12mv2/robo-bump-truck-build/docs/research/corrections.md

# Corrections

Author: Colin Rooney · © 2026 Rooney Industries LLC · MIT licence

This page lists numbers and claims from the research record that were withdrawn or corrected, and why. Each row gives what was said, what is said now, where each is recorded, and the date of the correction. Where a row replaces a figure, the figure on the other pages is the new one. The results are on [results](results.md), the instruments on [method](method.md), and the limits on [cannot-do-yet](cannot-do-yet.md).

One row, the weak direction, records two entries that disagree. It is not resolved.

## The truck and its parts

| Subject | What was said | What is said now | Where each is recorded | Date |
|---|---|---|---|---|
| Wheelbase | The record carried 0.269 m <!-- S:72 -->. An earlier controller used the same 0.269 m (pose_follow.py:50 at commit 14bc70a, code history). A rough tape gave 254 mm <!-- G:192 -->. Later the record said 0.28 m <!-- S:77 -->. | wheelbase: Traxxas spec 270 mm (https://traxxas.com/36054-8-110-stampede-xl-5-2wd-monster-truck-with-tq-radio; https://traxxas.com/36254-8-stampede-2wd-xl-5-wbattery, read 2026-10-10); measured 277.5 mm on this truck. The deployed controller does not use it; pure pursuit uses only the camera offset ahead of the rear axle, 0.24 m (src/orin/live_trail.py:2635 at f6ff42a, every run plan). The pages use the 277.5 mm measurement. <!-- spec: Traxxas pages linked inline; 277.5 mm: author's tape, 2026-10-10; 0.24 m: S:76, C:507 --> | Said: the research notes, the rough-tape table and the controller code. Now: the vendor pages and the author's tape. | 2026-10-10 |
| Camera height | The lens height was assumed to be about 300 mm <!-- F:400 -->, then measured at 260 mm <!-- F:400 -->. At 260 mm the look-ahead table was about 13 % optimistic, for example 0.83 m became 0.72 m at the normal pitch <!-- F:400 -->. | 290 mm from 2026-09-14, after spring spacers raised the truck <!-- F:1941, F:1947-1948 -->: 0.29 m to the upper lens, loaded and settled <!-- F:1947 -->, 0.2775 m fully compressed <!-- F:1948 -->. A ruler gave 0.29 m and the calibration images fit 0.29 to 0.31 m <!-- F:1941 -->. [Calibration](../calibration.md) uses 0.29 m. This is a change in the truck, not a mistake in the earlier measurement. | Said and now: the research log, entries of 2026-09-03 and 2026-09-14. | 2026-09-03 and 2026-09-14 <!-- F:400, F:1941 --> |
| Flight-controller connector margin | Any pocket, lip or wall on the tray would foul a connector on the flight controller. This was inferred from product photos <!-- F:468 -->. | There is a 2 mm clear margin on every face of the Pixhawk 6C Mini, including the top, before any connector. A 2 mm lip fouls nothing <!-- F:468 -->. A measurement outranks a photo. | Said and now: the research log, entry of 2026-09-05. | 2026-09-05 <!-- F:468 --> |
| Red light on the speed controller | Solid red on the XL-5 meant a low-voltage trigger <!-- F:976 -->. | Solid red means low-voltage detection is disabled (the NiMH setting). It is a power-on light, not a fault. Detection engaged is a slow blink and thermal shutdown a fast one <!-- F:976 -->. | Said and now: the research log, entry of 2026-09-08. | 2026-09-08 <!-- F:976 --> |
| Capture phone | The pose-capture phone was a co-mounted 14 Pro <!-- F:888 -->. | It is the 17 Pro. The 14 Pro never held pose outdoors: it lost it in 19 to 47 s on every 2026-08-29 session <!-- F:888 -->. | Said and now: the research log, entry of 2026-09-07. | 2026-09-07 <!-- F:888 --> |

## The oval and the steering head

| Subject | What was said | What is said now | Where each is recorded | Date |
|---|---|---|---|---|
| Bend radius of the tape oval | The bends had a 1.3 m radius, needing a curvature of 0.77 1/m <!-- F:1016, F:1030 -->. This figure is withdrawn. | The bend end radii are 0.65 to 0.82 m, from four sessions of phone pose, and need a curvature of 1.2 to 1.5 1/m <!-- F:1046, C:550-555 -->. The ceiling-camera circle fit gives 0.62 m for the tightest bend <!-- C:550-555 -->. These are two instruments on one tape and do not conflict; name the instrument when quoting either. | Said: research log, entry of 2026-09-09. Now: research log, entry of 2026-09-09. | 2026-09-09 <!-- F:1046 --> |
| Oval-head AUC | The steering head trained on the oval scored an AUC of 0.94 to 0.97 on held-out sessions <!-- F:1005 -->. This figure is withdrawn. | AUC is the wrong headline for this head. It is inflated by easy negatives: one patch of 34 per row is the centre, so ruling out the far edges scores well <!-- F:1031 -->. The honest numbers are a column error of 3 to 6 cm and a correlation of +0.49 with the driver <!-- F:1031, C:540-547 -->. The author caught it: the AUC looked too good to be true. | Said: research log, entry of 2026-09-08. Now: research log, entry of 2026-09-09. | 2026-09-09 <!-- F:1031 --> |

## Direction

| Subject | What was said | What is said now | Where each is recorded | Date |
|---|---|---|---|---|
| Turn direction sign | The weak direction was left turns. A 6 cm camera offset explained why the inside tape left the view sooner in a left turn <!-- F:1459 -->. | Positive curvature is a right steer. The weak direction is right turns, which is clockwise, the way the author drove <!-- F:1468, C:397-414 -->. The numbers stand: in right turns 8 to 13 rows were seen, 54 % of frames were gated and the command never exceeded 1.17; in left turns 15 rows were seen, 37 % were gated and the command reached 1.58 <!-- F:1468 -->. The 6 cm camera-offset explanation was told with the wrong sign and is withdrawn <!-- F:1468, C:397-414 -->. | Said: research log, entry of 2026-09-12. Now: erratum in the research log, 2026-09-13. | 2026-09-13 <!-- F:1468 --> |
| Weak direction, open conflict | An erratum of 2026-09-13 says the weak direction is right turns, clockwise <!-- F:1468, C:401-404 -->. | A later note, 2026-09-24, attributes the same command limit to turning left: "turning left the command never exceeded 1.17 1/m against a bend that needs ~1.6" <!-- F:1490-1491 -->. The two entries disagree on the side. This page does not resolve it. The statements on [results](results.md) name no side and say "its weak direction" <!-- C:417-418 -->. [Cannot-do-yet](cannot-do-yet.md) names clockwise once, quoting the corner-by-corner result of 2026-09-12 that the record allows <!-- C:414-416, F:1500-1501 -->; that result is not the one in conflict here. | Said and now: research log, the erratum of 2026-09-13 and the note of 2026-09-24. | 2026-09-13 and 2026-09-24 <!-- F:1468, F:1491 --> |

## Runs, gates and the controller

| Subject | What was said | What is said now | Where each is recorded | Date |
|---|---|---|---|---|
| The "v13 cell" | Five graded runs on 2026-09-11, with median worst cross-track errors of 0.065, 0.049 and 0.070 m at entry, apex and exit, were a steering-head result <!-- F:1297 -->. | The radio steered them. The [mode switch](../radio-and-controller.md) sat in the middle band and the steering-source dial at its low end, which gives the steering head a weight of 0.0 <!-- F:1290 -->. The cell was not driven. Quote the three numbers only as a hand-steered reference at cruise throttle <!-- F:1297, C:707-722 -->. The first graded set the steering head did steer that night read 0.126, 0.438 and 0.414 m <!-- F:1312 -->. | Said and now: research log, entry of 2026-09-11. | 2026-09-11 <!-- F:1290 --> |
| Gate counts | "The gates are quiet now: 28 gated frames of 3,633" <!-- F:1666 -->. | The gate field says 1,152 of 3,633 frames, 31.7 % <!-- F:1725 -->. The 28 counted states (13 low-row, 11 lane and 4 hold), not the gate. | Said and now: research log, entry of 2026-09-13. | 2026-09-13 <!-- F:1725 --> |
| Share of the line fitter | The fitter's straight-line fallback was worth about 10 % <!-- F:1656 -->. | Withdrawn as a decomposition. The replay left out the deployed row-vote mask. With it, uncapping the fit changed 333 of 1,065 fresh bend requests by more than 0.1, and on the 577 straight-fit bend frames the median change was −0.054, slightly less turning <!-- F:1728 -->. | Said and now: research log, entry of 2026-09-13. | 2026-09-13 <!-- F:1728 --> |
| Detection rejection rate | 99.2 % of false detections were rejected <!-- F:2196 -->. | The denominator was colour-mask-negative frames, not false detections. Of 259 such frames, 257 were gated and 2 were acted on <!-- F:2195 -->. A gated frame means the fresh camera fit was not used. It does not mean the truck stopped <!-- F:2196 -->. | Said and now: research log, entry of 2026-09-14 and 2026-09-15. | 2026-09-14 <!-- F:2196 --> |
| External stall guard | An external stall guard bounds a wound-up speed loop to 2.5 s <!-- F:1927-1928 -->. | The guard has been superseded by the motion checks in the recovery code, and the entry is kept as the measurement of the hazard. The truck still did not move on the retry <!-- F:1928 -->. See [pitfalls](../pitfalls.md) and [power and safety](../power-and-safety.md). | Said and now: the research log, one entry of 2026-09-14. | 2026-09-14 <!-- F:1928 --> |

## Instruments and capture

| Subject | What was said | What is said now | Where each is recorded | Date |
|---|---|---|---|---|
| Decoder latency | One frame held, 94 ms, and 227 ms from capture to record, on the Orin's hardware video decoder <!-- F:1534, F:1595-1596 -->. | Withdrawn as latency figures. The picture the steering head would steer on was 11 to 13 frames, 0.7 to 0.9 s, older than its tag, and the stamps were about 11 frames wrong <!-- F:1579, F:1595-1596 -->. The software-decoder figure of 287 ms stands <!-- F:1595-1596 -->. | Said: research log, entries of 2026-09-13. Now: the erratum of 2026-09-13, 02:20. | 2026-09-13 <!-- F:1579 --> |
| Ground-frame rotation | A per-pass rotation of a few degrees, up to 6.2°, was a rigid rotation of the phone's frame <!-- F:2419 -->. | It is not rigid in 45 of 55 passes, 82 % <!-- F:2463 -->. The rotation needed varied by a median of 7.75° along one pass, against 2.94° at the 90th percentile in a positive control <!-- F:2463 -->. What survives: the phone and gyro disagree most at the same corners every lap, up to 4.6 to 6.4° <!-- F:2463 -->. | Said and now: research log, entry of 2026-09-20. | 2026-09-20 <!-- F:2463 --> |
| Phone orientation and walk length | The phone was held landscape, and the capture walks lasted about 10 min <!-- C:122, C:123 -->. | The phone was held portrait <!-- C:17 -->. The walks were 213.6 s, 228.6 s and 91.8 s, or 3.6, 3.8 and 1.5 min, measured from the video files <!-- C:49, C:122-123 -->. | Said: earlier publication drafts. Now: corrected in those drafts the same day. | 2026-08-30 <!-- C:122-123 --> |
