12mv2/robo-bump-truck-build/prints/phone-cradle/v26_riser.stl

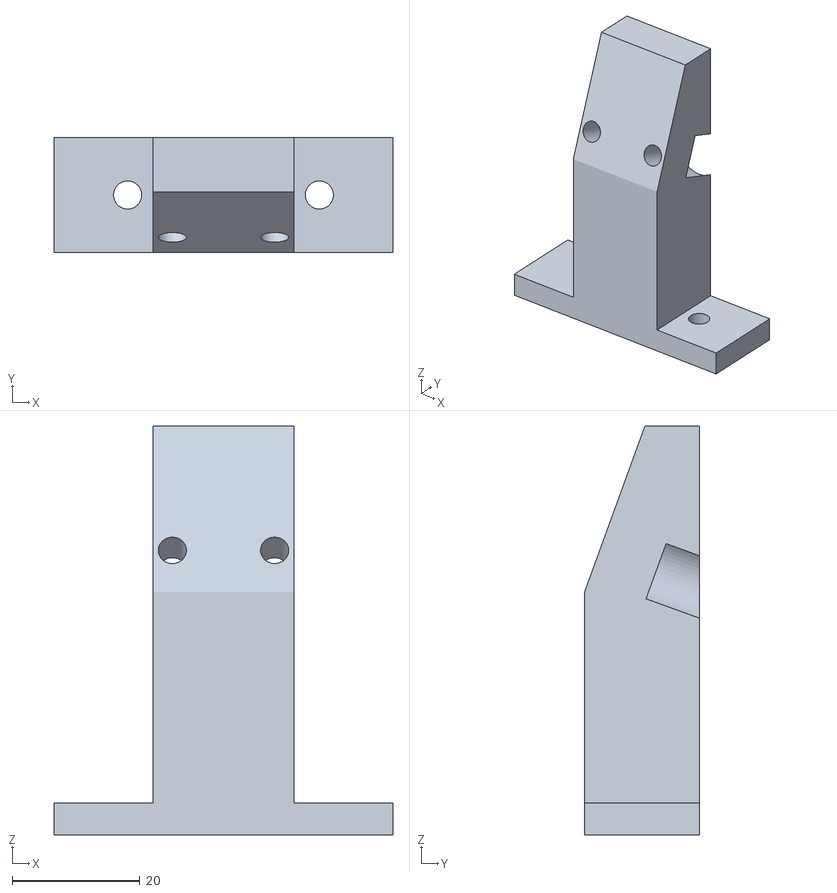
[picture p5: CAD file, 2026-10-20]
prints/phone-cradle/v26_riser.stl
53.0 x 18.0 x 64.0
