12mv2/robo-bump-truck-build/prints/phone-cradle/v66_tbar.stl

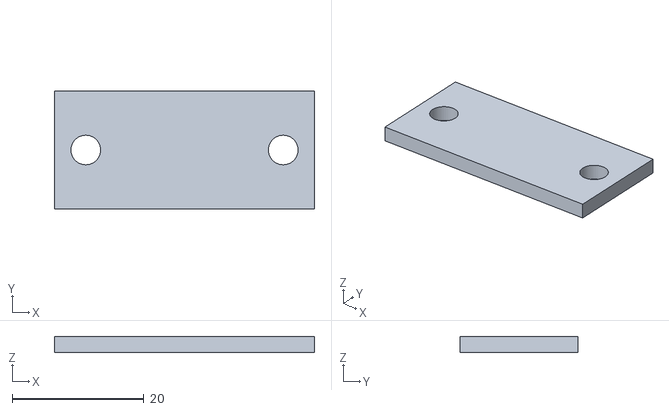
[picture p6: CAD file, 2026-10-20]
prints/phone-cradle/v66_tbar.stl
39.5 x 18.0 x 2.50
