12mv2/robo-bump-truck-build/prints/phone-cradle/v21b_pin.stl

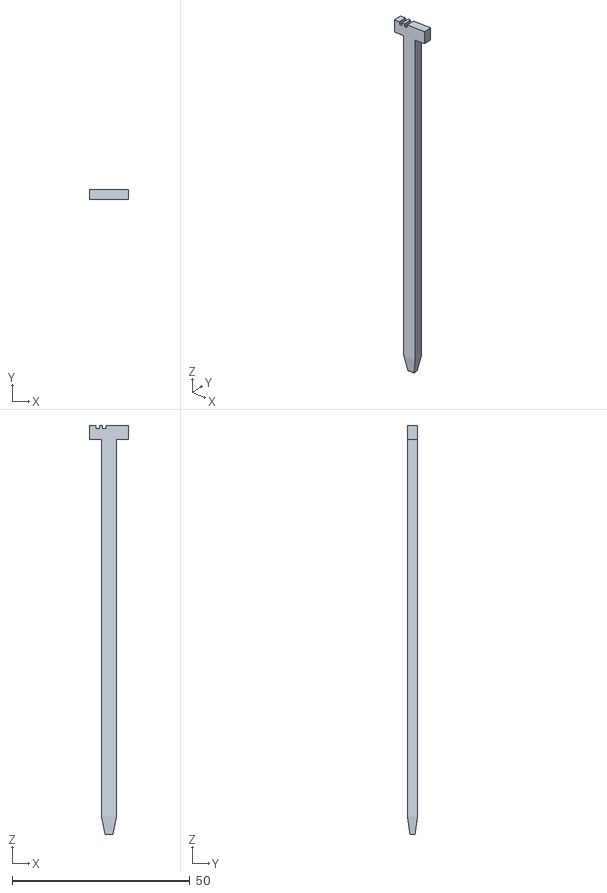
[picture p7: CAD file, 2026-10-20]
prints/phone-cradle/v21b_pin.stl
11.0 x 2.85 x 115.0
