12mv2/robo-bump-truck-build/prints/phone-cradle/v26_tray.stl

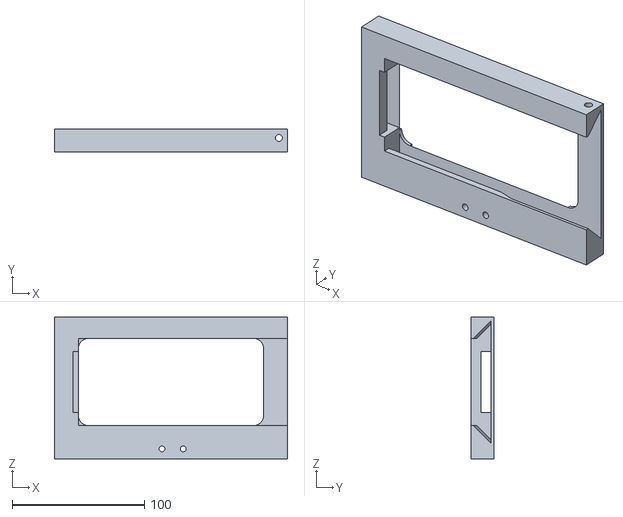
[picture p8: CAD file, 2026-10-20]
prints/phone-cradle/v26_tray.stl
176.0 x 17.2 x 107.0
