12mv2/robo-bump-truck-build/prints/phone-cradle/v10_wedge5.stl

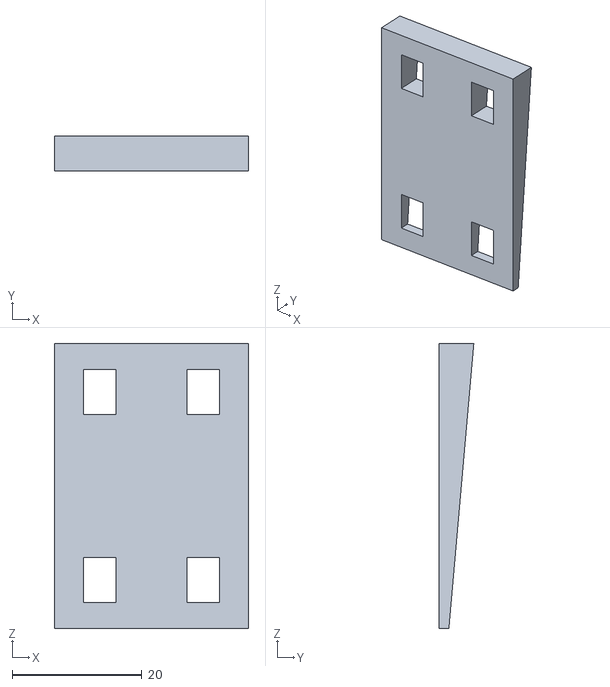
[picture p9: CAD file, 2026-10-20]
prints/phone-cradle/v10_wedge5.stl
30.0 x 5.35 x 44.0
