12mv2/robo-bump-truck-build/docs/build-checkpoints.md

# Build checkpoints

Author: Colin Rooney · © 2026 Rooney Industries LLC · MIT licence

Choose the checkpoint for your route; the public ROS interface is independent of unpowered assembly or cradle printing. The [physical build completion list](assembly.md#build-completion-list) is the canonical list of selected-mount checks and outstanding commissioning inputs. The full physical build remains the goal, but the historical guide is not a complete commissioned recipe or a validated current controller.

| Checkpoint | Actual prerequisites | Result and practical pass/stop observations | Availability |
|---|---|---|---|
| 1. Public ROS interface and outputs-disabled diagnostics | Supported ROS Linux host and the tools/dependencies in the [ROS README](https://github.com/12mv2/robo-bump-truck-ros#build-and-test); no vehicle, phone, prints or weights. | Build/tests plus actual topic delivery under the [shadow bridge guide](https://github.com/12mv2/robo-bump-truck-ros/blob/main/truck_bridge/README.md#build-and-run). Retain repeated normal, zero-speed and steering-handback diagnostics, with outputs disabled, and process shutdown observations. Stop if delivery is absent, publishers compete or status differs from the guide. | Public instructions and interface are available. Written readiness and unit tests do not establish a new ROS demonstration. |
| 2. Recorded-frame perception replay, no vehicle | Host/runtime from [Jetson and perception setup](https://github.com/12mv2/robo-bump-truck-ros/blob/main/docs/jetson-orin-setup.md), node-owner supplied node package, permitted model, configuration and usable recorded images with the expected format/calibration. Keep vehicle interfaces physically disconnected. | Observe decoded frames, node predictions and real ROS message/status delivery; record input/model/config identities and clean process exits. Stop on missing assets, decode/model errors or absent messages. A running process alone does not pass. | Setup guide and [agent brief](https://github.com/12mv2/robo-bump-truck-ros/blob/main/AGENT-BRIEF.md) are public; the interface repository does not supply the perception runtime, model, configuration or replay images. |
| 3. Physical assembly, radio, steering and camera commissioning | Verified [parts](parts.md), secure selected mounts (bands/straps and optional trays, or fitted [reference prints](prints.md)) and own-build [measurements](calibration.md). Establish a [simple manual baseline](radio-and-controller.md#start-simple) with manufacturer instructions and a known-working wheel/trigger setup; the stock radio can precede receiver changes. Advanced research mixes and compute ownership are optional later work. Manual use through Pixhawk requires correct firmware/configuration, owner-reviewed [radio/controller configuration](radio-and-controller.md#missing-commissioning-inputs) and [power isolation](power-and-safety.md#commissioning-and-isolation). | Later supervised bench evidence must show secure assembly, correct channel/direction/endpoints, neutral when disarmed, effective kill/manual override, link-loss and expiry behaviour. Stop for binding, unexpected output, missing configuration or unproven stopping. Future assisted powered drive also requires the controller boundary and acceptance in checkpoint 4. | Historical release identities, partial commissioning facts and five [phone-cradle reference prints](../prints/phone-cradle/README.md) are supplied; historical compute/FC carrier files and exact fitted identities are optional references, not unpowered-assembly prerequisites. Mounting and outputs-disabled ROS do not require advanced controls. Full firmware/parameter/mixer exports and the intended controller package remain outstanding. No new physical commissioning is established here. |
| 4. Intended-controller supervised first drive | Source-owner reviewed suitable controller/configuration, accepted bench evidence, verified stopping and supervised field plan under the [first-drive boundary](first-drive.md). Public ROS physical integration still needs an accepted output-owner path; the separate historical field relay is not supplied here; see [ROS connection](ros.md#how-it-connects-to-the-orin-stack). | Retain physical motion, stop, lane-loss/stale-intent, route-end and human-veto observations, plus shutdown/recovery evidence. Stop on any failure or unresolved throttle authority. | The historical field kit is identified separately. Its public package, rebuild instructions, full exports and new-build bench/field acceptance remain outstanding. Historical drives do not validate this snapshot for a new build. |

Node-owner assets not supplied by this repository (model/configuration/replay images) are separate from this truck's unpublished [OVAL4 head](../model/README.md) and unavailable [sample assets](../data/README.md). OVAL4 belongs only to the historical DINO truck snapshot, separate from the manually launched field kit; neither it nor sample logs are required for synthetic ROS. The described samples exclude video/images and cannot supply a recorded-frame replay. Historical perception also needs its local DINOv2 checkout/checkpoint and verified runtime setup; see [Orin setup](orin-setup.md). Robot Eyes is **CLOSED SOURCE**; [app distribution and device access](ros.md#robot-eyes-the-phone-app) are separate prerequisites for a later live-phone path.

The [separate dated field integration](ros.md#how-it-connects-to-the-orin-stack) did have powered use; it does not validate public `truck_bridge`. Source identity alone establishes neither a reproducible public package nor fresh physical acceptance.

In the historical snapshot source, omitting `--fc` selects compute-only operation. With `--fc --dry-run`, the program connects to the flight controller and exchanges telemetry/parameter traffic while actuator override sends are disabled; this is not physical disconnection or absence of protocol traffic. <!-- src/orin/live_trail.py:673-692,1584-1590,2062-2068,2158 -->

Keep evidence distinct: written prerequisites, build/tests, actual ROS transport and process exits, replay artifacts, physical commissioning and recovery, then full fresh-follow acceptance. No checkpoint is marked passed by this page. A fresh reader must eventually complete the first drive from the tagged guide and parts list without an author answer; intermediate demos do not establish that result. The first independent fresh-follow build will take place **after public release**; no pass has been recorded. This does not relax source-owner review or powered bench/field acceptance.
