12mv2/robo-bump-truck-build/prints/phone-cradle/INDEX.md

# Phone cradle package index

Start with [README.md](README.md) for fit limits, slicing and assembly.

| File | Contents |
|---|---|
| [README.md](README.md) | Reader instructions and recorded hardware |
| [MANIFEST.json](MANIFEST.json) | Author, licence, units, conversion and mesh hashes |
| [v26_tray.stl](v26_tray.stl) | Reference tray |
| [v26_riser.stl](v26_riser.stl) | Reference riser |
| [v66_tbar.stl](v66_tbar.stl) | Reference T-bar |
| [v21b_pin.stl](v21b_pin.stl) | Standard two-notch pin |
| [v10_wedge5.stl](v10_wedge5.stl) | Optional single 5° shim |
