12mv2/robo-bump-truck-build/src/orin/live_trail.py

#!/usr/bin/env python3
# SPDX-License-Identifier: MIT — © 2026 Rooney Industries LLC
"""LIVE trail-centre inference: iPhone -> DINOv2-S/14 (FP16) -> 385-param head -> line -> pure
pursuit -> RC override on the steering channel.  Rewritten 2026-09-06 (v2).

Current local control repair (2026-09-14): OutputOwner alone sends both channels,
at --wheel-hz in all switch positions. Frames publish an expiring Intent; every
cruise withdrawal inhibits restart until HOLD + bottom dial, pose standstill,
then raised dial in HOLD and an exit from HOLD. Optional --stall-recovery adds
one bounded XL-5 retreat, with validated FC configuration and downstream output
feedback. It remains off by default pending physical characterization. Command
tests are offline evidence; physical stopping acceptance is still required.

The learned head consumes RGB. The current controller also uses phone pose for
taught-path feed-forward, speed and motion checks, and live camera pitch when
requested. Depth-ahead and IMU shock telemetry are logged; they do not currently
provide obstacle-clearance or collision-stop control.

WHAT CHANGED FROM v1 (2026-09-06 review):
  * The line is drawn EXACTLY as validated against the operator's 53 strokes (line_rules_v1.py):
    mass-weighted per-row centroid, per-row confidence = mass within +-2 patches, keep rows with
    conf >= 0.4, mass-weighted cubic with quadratic/line fallback on a curvature cap.
    v1 used per-row argmax + a max-prob gate + an unweighted cubic, which was never measured.
    An offline check (not shipped) reproduces the validated line rules from THIS file's code.
  * Mount pitch is a flag (--pitch up|normal|down|<deg>), not a constant buried in the source.
  * The 6 cm camera-to-truck-centre offset is applied (FINDINGS 12).
  * It actually SENDS: RC_CHANNELS_OVERRIDE on the steering channel only, radio keeps every other channel.
    Release on exit, release after --hold-ms without a lane, sysid gate before the perception model loads.
  * --dry-run computes and logs everything and sends nothing (shadow mode while the operator drives).
  * v3 (2026-09-06, field iteration): every frame ALSO logs the radio (RC_CHANNELS: steering, throttle, mode switch, kill dial),
    the servo outputs (SERVO_OUTPUT_RAW 1/3), mode and armed state read back from the FC, and
    the 476x350 feed frame as a JPEG (feed/). In shadow mode the steering channel is the OPERATOR'S steering -- the free
    label grade_run.py fits gain/sign/lookahead against. In auto mode the steering channel is the override and
    servo1 proves it reached the wheels. --note records what changed for this run.
  * Every frame is logged (jsonl + probs npz + a jpg every --jpg-every frames) so a live run can
    be graded against strokes and replayed against any head afterwards.
  * --video runs the identical code path on a corpus rgb.mp4 -- no phone needed to test.
  * Optional --danger-head runs DangerNet on the same backbone pass (display/log only).
  * v6 (2026-09-08): OPTIONAL --cruise holds a fixed throttle on the RC throttle channel while the steering head
    steers, so a tuning pass is one cell (lookahead, gain) and not also a hand-throttle
    (ANALYSIS-2026-09-08-tuning-process 6B/9: "no sweep is interpretable" without it). Off by
    default; with no --cruise flag not one byte of the command path changes. The human's real
    trigger is read from the radio's trigger-copy mixer channel (the FC reports the OVERRIDE, not the stick,
    on an overridden channel -- the same trap the wheel copy solves for steering), and ANY
    trigger movement, HOLD, a mode change, a disarm or stale RC telemetry hands throttle straight
    back to the receiver.
  * v7 (2026-09-09): --min-rows refuses to steer on a line fitted through too few band rows and
    holds the last confident command instead (the sign reversal that lost the kitchen oval's
    corner happened on 6-9 rows). 0 = off, the pre-v7 behaviour exactly.
  * v8 (2026-09-09): OPTIONAL --kff CURVATURE FEED-FORWARD, off by default. Pure pursuit steers
    only on EXISTING lateral error, so it enters a bend late and runs wide at any gain -- bracketed
    from both ends on the kitchen oval in one hour (FINDINGS 36) and structural, not a knob
    (ANALYSIS-2026-09-08-tuning-process 9: Snider CMU-RI-TR-09-08 4.3, ETH MAP "drives wide in all
    corners"). kappa_total = kff*kappa_path + gain*kappa_pursuit, where kappa_path is the
    GROUND-FRAME curvature of the trail near the goal point, from a mass-weighted quadratic over
    the ground-projected per-row CENTROIDS in a window around the lookahead (see path_curvature:
    the tool's own fitted line is curvature-CAPPED and comes back straight on 84-97 % of bend
    frames, so its curvature is identically zero exactly where the term is needed). The
    feed-forward is clamped on its own (--kff-max) before the sum, needs more rows than the
    pursuit term (--kff-min-rows) plus its own window/points/residual test, and never fires on a
    frame --min-rows distrusts. With no --kff flag not one byte of the command path or of a frame
    record changes -- proven by a replay diff against v7. NOT YET BENCH-TESTED OR DRIVEN.
  * v9 (2026-09-09): the LINE FIT's curvature cap can be expressed in the GROUND FRAME
    (--cap-kappa, 1/m), and the fitted DEGREE is now logged on every frame (`fit_deg`). The
    shipped cap of 0.05 patches/row^2 is not a physical quantity: measured over 9 sessions it
    fires on 7.5 % of wedge-down and 17.9 % of wedge-up frames of the SAME trail, and it caps the
    line the controller sees at 0.6 1/m on the oval mount where the bend needs 1.2-1.5, so every
    tight bend arrives as a STRAIGHT LINE (FINDINGS 37, 87 % of tight frames). --cap-kappa keeps
    the same fallback chain and the same protection -- with no cap at all the fit reaches
    1,309 1/m on noise -- but asks the question in 1/m near the goal point, which is comparable
    with KAPPA_FULL_LOCK and roughly 4x more consistent across mounts (it is an upper bound, not
    an unbiased curvature -- calibration in `fit_ground_kappa`'s docstring). OFF by default (--cap-kappa 0 = the validated rule, byte
    for byte; `check_line_rules.py` still PASSES). Numbers and the recommended setting:
    research results (line-cap v2), FINDINGS 39.
  * v11 (2026-09-09 evening): OPTIONAL --fit-max-y <m>: only band rows within that ground distance
    VOTE in the line's polyfit; the line is still drawn, logged and counted (`kept`, --min-rows)
    on every kept row. Why: on corner-ENTRY frames the cubic sat 2.7 patches OUTSIDE the coming
    bend while the head's own far centroids were 1.2 off -- the fit was worse than its inputs,
    because band rows 0-2 (1.5-3 m ahead, where the tape has left the frame and the head reports
    the far side of the loop) drag the far end straight. Nothing in a 108-cell fitter sweep
    (confidence, weights, fit space, fallback) moved the entry by more than 0.04 patches; which
    rows vote did: rows <= 1.1 m voting took the entry goal-row error 1.11 -> 0.82 patches and
    the 1 m lateral error 6.6 -> 3.8 cm, bias gone, straight better too (0.48 -> 0.31). Cost: a
    flatter line inside the (blind) bend and 6 points more cap fallback there. Numbers:
    research results (line-fit sweep v3, H/I). The boundary is
    in METRES through --pitch (1.1 m = band rows 4-16 at 14.55 deg, 3-16 at 16.3), `fit_vote` is
    logged per frame when on. OFF by default: `check_line_rules.py` PASSES, and a whole-tool
    --video replay at the default is byte-identical to v10. NOT YET DRIVEN (pass 6 = pass 3 +
    --fit-max-y 1.12).

Run ON THE ORIN, phone tunnelled and Moblin LIVE:
    sudo usbmuxd --no-preflight
    iproxy 7790 7790 -u $(idevice_id -l | head -1) &
    python3 live_trail.py --head centre_head_lag0_r8c_v1_ALL-SESSIONS.npy --pitch up \
        --fc /dev/ttyACM0 --dry-run --log runs/shadow1          # shadow: log only
    python3 live_trail.py --head ... --pitch up --fc /dev/ttyACM0 --log runs/auto1   # closed loop

Geometry matches the training path exactly (feats_v1.py): 1920x1440 in, cv2.resize to 476x350
(INTER_LINEAR), BGR->RGB, /255, ImageNet mean/std, rows R0..24 of the 25x34 grid.
FP16 costs nothing: 18.9 ms vs 63.7 ms, AUC delta -0.0000 (FINDINGS 29).
"""
import argparse, glob, json, math, os, queue, signal, socket, struct, subprocess, sys, threading, time, warnings
from collections import deque
from dataclasses import asdict, replace
from pathlib import Path
import numpy as np
import launch_phase
from output_owner import Intent, OutputOwner, Pose, finite
from recovery import RecoveryConfig, HardwareProfile
from inspect_reverse import PARAMETERS as REVERSE_PARAMETERS, wait_rover_heartbeat

HOST_HELLO, DEVICE_HELLO, VIDEO_CONFIG, VIDEO_FRAME, STATUS = 1, 2, 3, 4, 0x10
START_RECORD, STOP_RECORD = 0x0A, 0x0B   # host -> phone: record on the phone without touching it (operator, 2026-10-02 23:0x).
                                           # `touch ~/live/RECORD_ON` starts a recording, removing the file stops it; the phone's
                                           # status `recording` is the receipt. Needs "Computer may start/stop recording" ON.
RECORD_FLAG = Path.home() / "live" / "RECORD_ON"
RECORD_SENT = [None]      # what we last asked for (True = start sent, False = stop sent)

STREAM_FLAG = Path.home() / "live" / "STREAM_FPS"   # 2026-10-02 23:4x (operator: "change it yourself"): a number in this file = the stream
STREAM_SENT = [None]                                 # target fps asked of the phone via 0x0C (k=1 native size); session-only on the phone.
SET_STREAM = 0x0C

def send_stream_flag():
    """Once a second: if ~/live/STREAM_FPS holds a number we have not sent on this connection, send 0x0C k=1 fps=N."""
    s = HOST_SOCK[0]
    if s is None: return
    try:                                              # file holds "fps" or "scale fps" (scale 1, 2, 4 or 12 = 1/k of 1920x1440)
        parts = STREAM_FLAG.read_text().split() if STREAM_FLAG.exists() else []
        want = (1, int(parts[0])) if len(parts) == 1 else (int(parts[0]), int(parts[1])) if len(parts) == 2 else None
    except (ValueError, OSError): want = None
    if want is None or want == STREAM_SENT[0] or want[0] not in (1, 2, 4, 12) or not (1 <= want[1] <= 60): return
    try:
        with HOST_TX_LOCK: s.sendall(struct.pack(">BI", SET_STREAM, 2) + bytes([want[0], want[1]]))
        STREAM_SENT[0] = want
        print(f"stream: asked the phone for 1/{want[0]} size at {want[1]} fps (0x0C; receipt = fps_stream and the videoConfig size)")
    except OSError: pass

def send_record_flag():
    """Once a second from the loop: reconcile the flag file with what we last sent."""
    send_stream_flag()
    s = HOST_SOCK[0]
    if s is None: return
    want = RECORD_FLAG.exists()
    if want == RECORD_SENT[0]: return
    try:
        with HOST_TX_LOCK: s.sendall(struct.pack(">BI", START_RECORD if want else STOP_RECORD, 0))
        RECORD_SENT[0] = want
        print(f"record: asked the phone to {'START' if want else 'STOP'} recording ({'touch' if want else 'rm'} {RECORD_FLAG})")
    except OSError: pass

HOST_STATE = 0x0D        # host -> phone (robot-eyes ticket 12, 2026-10-02): {"armed", "owner", "mode"} about once a second. The phone's
                         # HUD puts the word first (red while ARMED) and marks it "stale N s" 3 s after the last one, "NO ORIN" without a host.
HOST_SOCK = [None]       # the live phone connection, set by moblin_frames(); the loop sends on it, the reader thread only receives
HOST_TX_LOCK = threading.Lock()

def send_host_state(armed, owner, mode):
    """Tell the phone what the robot is doing. Never raises: a failure only leaves the HUD stale, which is the honest state."""
    s = HOST_SOCK[0]
    if s is None: return False
    body = json.dumps({"armed": armed, "owner": owner, "mode": None if mode is None else str(mode)}).encode()
    try:
        with HOST_TX_LOCK: s.sendall(struct.pack(">BI", HOST_STATE, len(body)) + body)
        return True
    except OSError: return False
DECODER = ["sw"]         # set from --decoder in main(); read by the reader thread when it spawns ffmpeg. sw since 2026-09-13 02:25 (see below)
AU_DELIM = [True]        # set from --au-delim in main(); read by the reader per access unit (see AUD below)
# 2026-09-13, external review round 3, rank 1 (verified on the Orin with last night's real 15 fps 8 Mbit stream): ffmpeg's
# raw hevc/h264 demuxer+parser cannot know an access unit has ENDED until the NEXT one begins, so on an Annex-B pipe every
# picture waited one frame period (67 ms) for its successor before the decoder even saw it. Appending one tiny NAL after each
# AU gives the parser its boundary at once: fed->decoded on the hardware path 93 -> 27 ms median, held frames 1 -> 0.
# WHICH NAL matters: an access-unit delimiter (nut 35) made hevc_nvv4l2dec emit one EXTRA picture during the start-up drain
# (picture 19 of 180, FIFO depth 3 at the time), which would have shifted every later stamp by a frame. An UNSPECIFIED NAL
# (nut 48, discarded by decoders, a boundary for the parser) does not: 180/180 pictures identical to the plain path, in order,
# two runs (an offline decoder test, not shipped; modes plain/aud/unspec). H264 (not the truck's codec) keeps the AUD; its parser does
# not end a frame on unspecified types. --au-delim off restores the old byte stream for A/B.
AU_END_HEVC = b"\x00\x00\x00\x01\x60\x01\x50"   # nut 48 (unspecified), layer 0, tid 1, one payload byte
AU_END_H264 = b"\x00\x00\x00\x01\x09\xf0"       # AUD type 9; primary_pic_type 7 + stop bit
DEC_MAX_DEPTH = 300     # access units ffmpeg may hold before we call it a desync -- a LEAK guard only. ffmpeg holds ~50 AUs
                        # (3.6 s) while it probes the stream at start-up, then catches up; measured 2026-09-12 on a synthetic 15 fps stream
# v12 (2026-09-10): what the phone says about itself, kept by moblin_frames() and logged per frame.
#   hello    the deviceHello JSON (utc_s, pitch_deg, app_version, files_port, ...) -- once per connect
#   status   the latest 1 Hz status JSON (stream_state, pitch_deg, enc_failed, recording, thermal, ...)
#   pts_us   the phone's timestamp of the IMAGE being processed (ARFrame.timestamp * 1e6 = odometry.csv's clock)
# None of it changes what the tool DOES unless --pitch live is set; it changes what the tool RECORDS, so a run and
# the phone's own session can be joined on one clock and a dead stream is visible in frames.jsonl.
# 2026-09-12 (external review, STANDING.md "Known defects" 1): until this date pts_us was set by the PACKET reader
# when a VIDEO_FRAME arrived, while the image the loop worked on came out of ffmpeg several access units LATER --
# so every logged pts_us belonged to the newest packet, not to the image (the review matched predictions to video
# ~0.5 s earlier than the logged stamp). The stamp now travels WITH the access unit through the decoder (a FIFO of
# pending stamps, popped in order as decoded frames emerge; the wire is display order: 09-12 logs show pts strictly
# monotonic at 66.7 ms). Two new fields measure what the old stamp hid:
#   pts_rx_us  the stamp of the newest packet RECEIVED when this image was yielded (old pts_us); pts_rx_us - pts_us
#              is the decoder's depth in phone time
#   dec_depth  access units still inside ffmpeg when this image came out (frames of pipeline latency)
#   clock_off  phone UTC minus Orin time.time(), the max over the last 30 status packets (least transport delay wins;
#              a WINDOW, not max-ever, because the Orin's wall clock was stepped 2.3 s mid-run on 2026-09-12 and a
#              max-ever estimate then inflated age_ms for the rest of the run -- external review 2026-09-13), so
#              age_ms = capture-to-record latency on the phone's own clock (pose.t_utc/t_us are the same clock as pts)
# v15 (2026-09-13, round-4 review): a timestamped history of the phone's poses, written by the reader thread from every
# status packet that carries a NEW pose_seq. The frame loop reads the newest; nothing else in the loop changes.
POSES = deque(maxlen=64)
OUTPUT_POSE = None                    # immutable receive-stamped sample for the independent sender
def note_pose(st):
    global OUTPUT_POSE
    pz = st.get("pose") if isinstance(st, dict) else None
    if isinstance(pz, dict) and isinstance(pz.get("t_utc"), (int, float)) and isinstance(pz.get("x"), (int, float)):
        seq = st.get("pose_seq")
        if not POSES or POSES[-1][0] != seq or seq is None:
            POSES.append((seq, float(pz["t_utc"]), float(pz["x"]), float(pz.get("z", 0.0)), pz.get("heading_deg"), pz.get("v_mps"), pz.get("tracking"), st.get("recording")))
            received = time.monotonic()
            off = PHONE["clock_off"]
            age = time.time() + off - pz["t_utc"] if finite(off) else float("inf")
            tracking = pz.get("tracking")
            if OUTPUT_POSE is not None and st.get("recording") == OUTPUT_POSE.recording:
                if pz["t_utc"] <= OUTPUT_POSE.stamp: tracking = "nonadvancing"
            OUTPUT_POSE = Pose(seq, pz["t_utc"], received, age, pz["x"], pz.get("z"),
                               pz.get("v_mps"), tracking, st.get("recording"),
                               math.radians(pz["heading_deg"]) if finite(pz.get("heading_deg")) else None)
PHONE = {"hello": None, "status": None, "video_config": None, "status_t": 0.0, "pts_us": None, "pts_rx_us": None, "dec_depth": None,
         "clock_off": None, "clock_offs": deque(maxlen=30), "dec_desync": 0,
         "t_rx": None, "t_dec": None, "t_take": None, "skipped": None}   # async ingest stage stamps (monotonic) + frames skipped
# CLOCKS (external review 2026-09-13): every LOCAL timer -- watchdog, holds, latches, freshness, intervals -- uses
# time.monotonic(); time.time() appears only where a wall clock is the point: the record's "t", the hello/status
# offset, and age_ms. The Orin's wall clock is set from the phone by auto_boot and can step mid-run.
PHONE_LOG_KEYS = ("stream_state", "pitch_deg", "roll_deg", "thermal_name", "fps_capture", "fps_stream", "enc_failed",
                  "enc_consecutive_failed", "enc_last_status", "recording", "record_seconds", "disk_free_mb", "low_power", "battery", "utc_s",
                  # 2026-09-12: the pose contract. They appear in rec["phone"] only when the phone sends them, so a
                  # phone without the pose build leaves the record byte for byte as before. `pose` carries
                  # {x, y, z, yaw_deg, heading_deg, v_mps, t_utc, t_us, tracking} -- STEER ON heading_deg, never yaw_deg
                  # (walk test 2026-09-12, session afbfee6219: heading tracks travel to -9.1 deg, yaw wanders -65..-90).
                  "pose", "depth_ahead_m", "imu_a_peak", "pose_seq")
SC = b"\x00\x00\x00\x01"
FEED_W, FEED_H, PATCH = 476, 350, 14
GW, GH = FEED_W // PATCH, FEED_H // PATCH        # 34 x 25
SRC_W, SRC_H = 1920, 1440
# Intrinsics of the corpus capture (camera_matrix.csv, all 33 files agree). Moblin sends no
# intrinsics; Back Wide at 1x is ~70.7 deg HFOV against 70.2 from fx, close enough (FINDINGS 19).
FX, FY, CX, CY = 1365.6527, 1365.6527, 958.99664, 723.1488
CAM_H = 0.26                 # m, SPEC 2b MEASURED lens height (0.30 is retired)
CAM_OFFSET_X = 0.06          # m, camera is 6 cm LEFT of truck centre (FINDINGS 12)
# Pose-derived mount pitch, degrees below horizon, per session (FINDINGS 12, field ledger):
#   normal 19.7/20.1  wedge-down 24.5/24.5  wedge-up 14.4/14.7
PITCH_PRESETS = {"normal": 19.9, "down": 24.5, "up": 14.55}
# EMPIRICAL, not kinematic (SPEC 3): the operator's 140 cm circle -> R 0.70 m at full lock.
# v10 (2026-09-09): this module constant is now only the DEFAULT of --kappa-full-lock. FINDINGS 38
# measured the plant from pose + servo1 on data already on disk:
#     |kappa| = 0.004778 * |servo1 - SERVO1_TRIM| / (1 + 0.22 v^2)   ->  full lock 1.734/(1+0.22 v^2)
# i.e. 1.66 1/m at 0.45 m/s (kitchen oval), 1.42 at ~1 m/s (trail). The constant below is 16 % low
# indoors. It is NOT changed here because gain and this number multiply (steer = gain*kappa/KFL):
# raising it silently lowers every measured gain by the same factor. Pass --kappa-full-lock and
# rescale --gain by new/old in the same edit (FINDINGS 36 bracket at 1.43: gain 1.0 -> 1.16, 2.0 -> 2.32;
# the 2.0 end was saturating, so it is a different setting under the raised clip, not a rescaled one).
KAPPA_FULL_LOCK = 1.0 / 0.70
# Line rules as validated (results/line_rules_v1.md): conf 0.4, curvature cap 0.05 patches/row^2
DEFAULT_CONF, DEFAULT_CAP = 0.4, 0.05

# --- cruise throttle (v6, 2026-09-08) --------------------------------------------------------
# Throttle is the RC throttle channel on this vehicle (RCMAP_THROTTLE = 2, VERIFIED at startup -- assuming
# the channel is exactly what caused the 2026-09-06 runaway, FINDINGS 30b / arm_guard.py guard 1).
CRUISE_THR_NEUTRAL = 1500     # fallback only; RC2_TRIM is read from the FC when it answers
CRUISE_THR_DZ = 30            # fallback only; RC2_DZ is read from the FC when it answers
CRUISE_SPAN_US = 250.0        # speed dial 1000..2000 us -> neutral .. neutral + 250 us of throttle.
                              # A trim click is ~65 us on the channel (measured for the speed dial, FINDINGS
                              # 30g) = 16.25 us of throttle; ~31 clicks span stopped -> ceiling.
CRUISE_ABS_MAX = 1800         # the tool REFUSES any ceiling above this, whatever the flags say.
                              # Measured field speeds: ~1650-1700 us gave 0.4-1.4 m/s (ANALYSIS 1).
CRUISE_RC_MAX_AGE_MS = 250    # RC_CHANNELS is requested at 50 Hz; 250 ms = 12 missed frames
CRUISE_MIN_BAND = 20          # floor on the trigger neutral band and on the "stopped" margin

# --- v15.2 speed setpoint (2026-09-13 18:1x, operator at the truck: "one click is crawl or too fast") ------------
# A dialled PWM is not a speed: the pack sags inside a session and the same PWM gave 0.16-0.48 m/s on one click
# and 0.80-0.90 on the next (FINDINGS 67). --cruise-mps makes the speed dial dial METRES PER SECOND and a PI trim on the
# throttle PWM holds it, using the phone's own 15 Hz pose speed. Feed-forward from TODAY'S measured floor:
# 1640 us -> ~0.30 m/s and 1655 -> ~0.80 (run auto-boot-160828), i.e. 30 us per m/s through v = 0 at 1631 us.
# These are the pack and floor of 2026-09-13; the integrator carries whatever the day's plant actually is.
CRUISE_FF_US = 1631.0         # PWM at which this truck starts to roll (feed-forward intercept)
CRUISE_US_PER_MPS = 30.0      # feed-forward slope
CRUISE_MPS_ABS_MAX = 1.5      # the tool REFUSES a setpoint band above this, whatever the flags say

# ---------------------------------------------------------------------------------------------
# 1. The line -- byte-for-byte the logic of line_rules_v1.py (fit() + conf), nothing else.
#
# v9 (2026-09-09): the fallback test may OPTIONALLY be made in the GROUND FRAME (--cap-kappa).
#
# WHAT THE CAP IS FOR. `cap` rejects a fit that bends more than `cap` patches per row squared and
# steps down cubic -> quadratic -> straight line. It exists to stop a high-degree polynomial
# swinging wildly through a noisy or collapsed set of rows and handing pure pursuit a goal point
# at nothing. That failure is real: with no cap at all the fitted line's own ground curvature
# reaches 1,309 1/m (a 1 mm radius) on the kitchen oval -- pure noise read as a hairpin.
#
# WHY THE UNIT IS WRONG. `patches per row squared` is not a physical quantity. A band row maps to
# a ground distance through the mount pitch, and the map is strongly non-linear: wedge-up the 17
# rows span 3.07 m down to 0.30 m, wedge-down 0.98 m down to 0.21 m. The SAME ground curvature
# therefore produces very different image curvature on different mounts, and 0.05 means different
# things on each. Measured over the five trail corpus sessions, the shipped cap fires on 7.5 % of
# wedge-down frames and 17.9 % of wedge-up frames of the same trail. On the kitchen oval it fires
# on 87 % of the frames whose true path curvature is above 0.9 1/m (FINDINGS 37) and hands the
# controller a STRAIGHT LINE through the bend.
#
# WHAT 0.05 ACTUALLY ALLOWS. Converting every accepted fit to its ground-frame curvature at the
# goal (2,338 moving oval frames, 6,689 trail, LOSO heads): under `cap 0.05` the line the
# controller sees can NEVER exceed 0.6 1/m on the oval mount and 2.6 1/m on the trail mounts. The
# oval's bends need 1.2-1.5 1/m (FINDINGS 37). The cap is not a filter there, it is a ceiling
# below the answer.
#
# WHAT --cap-kappa DOES. Same fallback chain, same code, but the test is "does this fit imply a
# ground curvature above `kappa_max` anywhere near the goal point?" -- one number, in 1/m, that
# is directly comparable with KAPPA_FULL_LOCK and means MUCH more nearly the same thing on every
# mount and lookahead (about 4x more comparable; see the calibration in `fit_ground_kappa`). The window is [0.6, 1.4] x lookahead, the same window `path_curvature` was
# validated on (FINDINGS 37), clamped into the rows the fit actually spans so it is never empty.
#
# MEASURED (results/line_cap_v2.md, 2026-09-09, LOSO heads, error = median |line - the driver's
# own path| in patch columns):
#   oval  cap 0.05 -> p50 0.87, within-1 0.57, p90 2.49, 67.5 % of frames a STRAIGHT LINE
#         cap-kappa 2.86 -> p50 0.73, within-1 0.64, p90 2.19, 10.8 % straight; ceiling 2.9 1/m
#   trail cap 0.05 -> p50 1.24, within-1 0.38, p90 3.66, 12.2 % straight; ceiling 2.6 1/m
#         cap-kappa 2.86 -> p50 1.23, within-1 0.39, p90 3.66,  2.0 % straight; ceiling 2.9 1/m
# The straight-line fallback is worse than the cubic against the driver's own path on 8 OF THE 9
# sessions, oval and trail alike (on the ninth the QUADRATIC is best and the cubic worst -- degree
# 2 would have been right there, degree 1 was not) -- and `line_rules_v1.md`'s own table already
# showed the cap never improving the stroke score (rule B: p50 0.75 -> 0.76, within-1 0.61 -> 0.59).
#
# STILL DEFAULT-OFF. --cap-kappa 0 is the shipped default and reproduces the validated behaviour
# byte for byte (`check_line_rules.py` PASSES unchanged). The trail numbers above are neutral, not
# better, and FINDINGS 36's standing consequence applies: an offline frame-by-frame comparison
# does not rank closed-loop settings. Turn it on for the oval, drive it, then decide about trail.
# ---------------------------------------------------------------------------------------------
CAP_WIN_NEAR, CAP_WIN_FAR = 0.6, 1.4      # --cap-kappa window, as multiples of the lookahead
CAP_KAPPA_SAMPLES = 41                    # curve samples across the fitted row span
DEFAULT_CAP_KAPPA = 2.0 * KAPPA_FULL_LOCK  # 2.86 1/m: the line may not claim a bend more than
                                           # twice as tight as the truck's own full lock. Only
                                           # used as the *suggested* value; the default is OFF.
                                           # NOTE (FINDINGS 38, same day): KAPPA_FULL_LOCK itself
                                           # is now measured at 1.66 1/m at 0.45 m/s, not 1.43, and
                                           # is speed-dependent. When that correction lands this
                                           # expression follows it (-> 3.32) but a literal
                                           # `--cap-kappa 2.86` written into auto.conf will NOT.
                                           # The measurements in line_cap_v2.md were taken at 2.86
                                           # and the calibration there is geometric, not vehicle-
                                           # dependent, so they stand either way.

def fit_ground_kappa(cf, r_lo, r_hi, r0, pitch, cam_h=CAM_H, y_lo=None, y_hi=None,
                     n=CAP_KAPPA_SAMPLES):
    """Max |ground-frame curvature| (1/m) of an image-space fit `cf` (patch column = P(band row)).

    The fitted line is a polynomial in the BAND ROW; `ground_point` turns a (row, column) pair into
    a ground (x right, y forward) pair through smooth analytic functions of the row alone, so the
    ground curve the controller will consume is itself a smooth function of the row and its
    curvature can be computed exactly -- no circle fit, no differencing of noisy data (FINDINGS 37
    rejected an algebraic circle fit for exactly that: it read noise as curvature).

    `y_lo`/`y_hi` restrict the search to a distance window (the goal region), CLAMPED into the
    span the fit covers so it is never empty -- a wedge-down mount at --lookahead 2.0 sees no
    ground past 0.98 m and would otherwise have no window at all.
    Returns inf for a fit that runs through the horizon, i.e. reject.

    THIS IS AN UPPER BOUND, NOT AN UNBIASED CURVATURE. A cubic fitted in IMAGE space is not a
    circle in the GROUND frame, so it overshoots locally where the far rows are sparse. Calibrated
    against synthetic arcs at the real band-row distances (results/line_cap_v2.md 1b, Ld 0.8 on all
    three mounts): a true 1.00 1/m reads 1.62 wedge-up / 2.31 normal / 2.09 wedge-down. THE READING
    MOVES 1.4-3.0x ACROSS MOUNTS, against 1.5-10.7x for patches/row^2 -- far more comparable, NOT
    perfectly mount-neutral, and it depends on --lookahead through the window. It errs toward
    rejecting, which is the safe direction for a rejection test. The unbiased estimator is `path_curvature` (FINDINGS 37); it
    is not used here because it is a fit to data and a rejection test must not be fooled by the
    same noise it is meant to catch.
    """
    th = math.radians(pitch); s_th, c_th = math.sin(th), math.cos(th)
    r = np.linspace(r_lo, r_hi, n)
    yc = ((r + r0 + 0.5) * SRC_H / GH - CY) / FY
    y_w = s_th + yc * c_th
    z_w = c_th - yc * s_th
    if np.any(y_w <= 1e-6) or np.any(z_w <= 0): return float("inf")
    t = cam_h / y_w
    x = t * ((np.polyval(cf, r) * SRC_W / GW - CX) / FX) - CAM_OFFSET_X
    y = t * z_w
    dr = r[1] - r[0]
    xp = np.gradient(x, dr); yp = np.gradient(y, dr)
    xpp = np.gradient(xp, dr); ypp = np.gradient(yp, dr)
    k = np.abs(xp * ypp - yp * xpp) / np.maximum((xp * xp + yp * yp) ** 1.5, 1e-12)
    m = np.ones(n, bool); m[:2] = False; m[-2:] = False     # gradient endpoints are one-sided
    if y_lo is not None:
        lo, hi = max(y_lo, float(y.min())), min(y_hi, float(y.max()))
        if hi > lo:
            w = m & (y >= lo) & (y <= hi)
            if w.sum() >= 3: m = w
    return float(np.nanmax(k[m])) if m.any() else float("inf")

def line_from_probs(prob, conf_thr=DEFAULT_CONF, cap=DEFAULT_CAP, curve=None, info=None, vote=None):
    """prob (NR,34) -> (line (NR,) patch-centre column or nan, conf (NR,), mass (NR,), cent (NR,)).

    mass-weighted centroid of the above-0.5 probability, per-row confidence = fraction of that
    mass within +-2 patches of the centroid, keep rows with conf >= conf_thr, then a mass-weighted
    cubic; if its second derivative exceeds `cap` anywhere fall back to quadratic, then to a line.
    Columns are in patch-centre units (col+0.5), i.e. 0.5 .. 33.5.

    `curve` (v9, OPTIONAL) replaces the patch-space cap with the ground-frame one:
    (kappa_max 1/m, r0, pitch deg, cam_h m, y_lo m, y_hi m). Same chain, physical units -- see the
    block comment above. `curve=None` is the shipped default and the validated behaviour.
    `info` (optional dict) is filled with `deg` (the degree actually used, 0 = no line) and, when
    `curve` is on, `kappa` (the accepted fit's own ground curvature) -- diagnostics only, so that a
    fallback to a straight line is VISIBLE in the log instead of silent.
    `vote` (v11, OPTIONAL) is a bool mask (NR,) of the rows ALLOWED TO VOTE in the polyfit. `keep`
    and `ok` are unchanged; the polynomial is fitted through `ok & vote` only, then evaluated on
    every `ok` row as before, so the far rows keep their ground points for the display, the log
    and `kept`. The `curve` cap samples the voting span, exactly as line_fit_sweep_v3 scored it;
    the patch-space `cap` still tests every drawn row. Needs >= 4 voting rows (else no line, the
    same path as < 4 kept rows). `vote=None` (the default) = every kept row votes, byte for byte
    the validated behaviour. `info["vote"]` = the number of rows that voted.
    """
    NR = prob.shape[0]; rr = np.arange(NR)
    wm = np.clip(prob - 0.5, 0, None) ** 2; m = wm.sum(1)
    cols = np.arange(34) + 0.5
    cent = np.array([(wm[q] * cols).sum() / m[q] if m[q] > 0 else np.nan for q in range(NR)])
    conf = np.array([wm[q][max(0, int(cent[q]) - 2):int(cent[q]) + 3].sum() / m[q]
                     if m[q] > 0 and not np.isnan(cent[q]) else 0.0 for q in range(NR)])
    keep = conf >= conf_thr
    ok = keep & ~np.isnan(cent); line = np.full(NR, np.nan)
    vo = ok if vote is None else (ok & np.asarray(vote, bool))     # rows that VOTE; `ok` = rows drawn
    if info is not None: info["deg"] = 0; info["kappa"] = None; info["vote"] = int(vo.sum())
    if ok.sum() < 4 or vo.sum() < 4: return line, conf, m, cent
    for deg in ((3, 2, 1) if (cap or curve) else (3,)):
        if vo.sum() <= deg: continue
        cf = np.polyfit(rr[vo], cent[vo], deg, w=np.sqrt(m[vo]))
        if curve is not None:
            kg = (0.0 if deg == 1 else
                  fit_ground_kappa(cf, rr[vo].min(), rr[vo].max(), curve[1], curve[2], curve[3],
                                   curve[4], curve[5]))
            good = deg == 1 or kg <= curve[0]
        else:
            kg = None
            good = cap is None or deg == 1 or \
                np.abs(np.polyval(np.polyder(cf, 2), rr[ok])).max() <= cap
        if good:
            line[ok] = np.polyval(cf, rr[ok])
            if info is not None: info["deg"] = deg; info["kappa"] = kg
            return line, conf, m, cent
    return line, conf, m, cent

# ---------------------------------------------------------------------------------------------
# 2. Rig geometry: an image point on a patch row -> a ground point in the TRUCK frame
# ---------------------------------------------------------------------------------------------
def ground_point(row_abs, col_pc, pitch_deg, h=CAM_H):
    """Absolute grid row (0..24) and patch-centre column (0.5..33.5) -> (x right, y forward) m,
    in the truck frame (camera offset removed). None if the ray is at/above the horizon.
    Exact pinhole ray rotated by the measured pitch, intersected with flat ground."""
    th = math.radians(pitch_deg)
    v = (row_abs + 0.5) * SRC_H / GH
    u = col_pc * SRC_W / GW
    xc, yc = (u - CX) / FX, (v - CY) / FY
    y_w = math.sin(th) + yc * math.cos(th)            # downward component after pitch
    if y_w <= 1e-6: return None
    t = h / y_w
    z_w = math.cos(th) - yc * math.sin(th)
    if z_w <= 0: return None
    return t * xc - CAM_OFFSET_X, t * z_w

def horizon_row_px(pitch_deg):
    """Image row (px of 1440) where flat ground meets the sky for this pitch -- an eyeball check
    that the mount is what --pitch says: ~373 px (26%) wedge-up, ~234 (16%) normal, ~101 down."""
    return CY - FY * math.tan(math.radians(pitch_deg))

# ---------------------------------------------------------------------------------------------
# 2b. v15 TAUGHT-PATH FEED-FORWARD (2026-09-13, after the round-4 review; STANDING section 1: teach-and-repeat = a taught path's
# curvature as feed-forward PLUS the camera as the correction; FINDINGS 63-65).  OFF unless --path is passed; byte-identical off.
#
# What it does, per frame, when --path is on and the phone's pose is usable:
#   * the pose (phone) is moved to the REAR AXLE with the body heading if the path was taught at the axle (meta ref_point),
#     predicted forward by the pose's own age (+ --ff-act-s) with the last commanded curvature, and localised on the path with a
#     direction-aware window; DIRECTION comes from the pose heading against the path tangent, never from the camera's command;
#   * FRESH frame (the camera steered this frame):  u = (1 - w) * kappa_ref + w * kappa_cam   (kappa_cam = today's gained, clipped,
#     EMA'd camera command; the reference is NOT filtered and NOT gained -- it is raw 1/R at the truck's convention, + = RIGHT);
#   * GATED / held / released frame: the camera term is WITHDRAWN and the reference keeps advancing:  u = kappa_ref  -- bounded by
#     --path-max-blind-m of travel without an accepted camera frame (0.5 m: round 4 would not certify 2 m; derive longer from data);
#   * pose stale (> --pose-max-age-ms), tracking not normal, off the path (> --path-max-dist-m), or the ALIGNMENT INVALID after a
#     reset / jump / re-position (position or heading jump incompatible with v*dt, recording id change, pose_seq going backwards)
#     -> no path term: v13 behaviour exactly (hold, then release).  An invalid alignment stays invalid for the run (path_epoch
#     counts them); re-teach and restart.  The truck is never steered from an old map through a turn.
# Replay of FINDINGS 65: on the 199 ms drive the whole exit gain of a 50/50 blend came from the held frames (1.00 -> 1.30); the
# fresh-frame blend changed nothing at the exit.  So the withdraw-on-gate rule is the experiment, not a detail.
# ---------------------------------------------------------------------------------------------
class TaughtPath:
    """record_path.py npz in the phone's CURRENT ARKit frame (xy, s, heading, kappa, sections, centre, meta)."""
    CAM_FWD_M, CAM_LEFT_M = 0.24, 0.06     # STANDING: lens 0.24 m ahead of the rear axle, 0.06 m left of the centreline (operator, tape, twice)
    def __init__(self, fn):
        z = np.load(fn, allow_pickle=True)
        self.xy = np.asarray(z["xy"], float); self.s = np.asarray(z["s"], float); self.kappa = np.asarray(z["kappa"], float)
        # v15.6 (2026-09-19, "out-and-back"): a route may be OPEN -- a straight or a corner taught there-and-back has a first
        # point and a LAST point. record_route.py writes closed=False; every path before it is closed and reads exactly as before.
        self.closed = bool(z["closed"]) if "closed" in z.files else True
        if self.closed: self.length = float(z["L"]) if "L" in z.files else float(self.s[-1] + math.hypot(*(self.xy[0] - self.xy[-1])))
        else: self.length = float(self.s[-1])                       # no closing chord on an open route
        self.sections = [str(x) for x in z["sections"]] if "sections" in z.files else ["?"] * len(self.xy)
        self.meta = {}
        if "meta" in z.files:
            try: self.meta = json.loads(str(z["meta"]))
            except Exception: self.meta = {}
        h = np.asarray(z["heading"], float)
        unit = str(z["heading_unit"]) if "heading_unit" in z.files else ("deg" if np.abs(h).max() > 2 * math.pi + 1e-6 else "rad")
        if unit == "deg": h = np.radians(h)
        if self.closed: d = np.roll(self.xy, -1, 0) - np.roll(self.xy, 1, 0)
        else: d = np.gradient(self.xy, axis=0)                      # open: no chord between the two ends
        h_xy = np.arctan2(d[:, 1], d[:, 0])
        dis = np.degrees(np.abs((h - h_xy + math.pi) % (2 * math.pi) - math.pi))
        self.heading_rebuilt = bool(np.median(dis) > 10.0)
        self.heading = h_xy if self.heading_rebuilt else h        # a heading that disagrees with its own xy is never used (FINDINGS 64)
        self.ref_point = self.meta.get("ref_point", "phone"); self.mount_yaw = float(self.meta.get("mount_yaw_motion_deg", self.meta.get("mount_yaw_deg", 0.0)))
        self.out_and_back = bool(self.meta.get("out_and_back", False))   # v15.6.1: two legs on one trail -> heading breaks the cold-start tie
        self.n = len(self.xy)
    def axle(self, x, z, heading_rad):
        """Phone floor position -> rear-axle centre, with the body forward axis = look axis minus the mount yaw."""
        if self.ref_point != "axle": return x, z
        h = heading_rad - math.radians(self.mount_yaw); fx, fz = math.cos(h), math.sin(h); rx, rz = -fz, fx      # right = (f x up) on the floor
        return x - self.CAM_FWD_M * fx + self.CAM_LEFT_M * rx, z - self.CAM_FWD_M * fz + self.CAM_LEFT_M * rz
    def ds_from(self, idx):
        """Signed arc length of every point from idx: wrapped to (-L/2, L/2] on a closed path, plain on an open route (v15.6)."""
        if self.closed: return (self.s - self.s[idx] + self.length / 2) % self.length - self.length / 2
        return self.s - self.s[idx]
    def remaining_m(self, idx, direction=1):
        """v15.6: metres of route left AHEAD of idx in the direction of travel. Closed paths never run out (inf)."""
        if self.closed: return float("inf")
        return float(self.length - self.s[idx]) if direction >= 0 else float(self.s[idx])
    def nearest(self, x, z, last_idx=None, direction=1, ahead_m=1.5, back_m=0.5, heading=None):
        """Nearest path index; with last_idx only points within (back_m behind, ahead_m ahead) IN THE DIRECTION OF TRAVEL are candidates.
        v15.6.1 (2026-09-20, the out-and-back LOOP, record_route.py --loop): a loop taught out and back on one trail has two legs
        lying on top of each other, running opposite ways. A cold start (no last_idx) or a relocalisation (window empty) picks by
        distance alone, and on such a loop that is a coin toss -- and the losing side is NOT harmless: read backwards, a
        turnaround's exit is not its approach, so at the marker the reference would steer up the exit curve while the truck is
        still on the straight (bench, tests/test_route_loop.py). So on a loop whose file says `out_and_back` (meta, written by the
        recorder) and with `heading` (body heading, rad): if the nearest point's tangent is more than 90 deg from the heading, the
        nearest point within 3 m whose tangent AGREES is taken instead. Every other path lacks the flag and reads exactly as
        before (2,000-pose bench); the windowed search is untouched on every path."""
        d = np.hypot(self.xy[:, 0] - x, self.xy[:, 1] - z)
        if last_idx is not None:
            ds = self.ds_from(last_idx)
            if direction < 0: ds = -ds
            m = (ds >= -back_m) & (ds <= ahead_m)
            if m.any(): cand = np.where(m)[0]; j = int(cand[np.argmin(d[cand])]); return j, float(d[j])
        j = int(np.argmin(d))
        if heading is not None and self.out_and_back and math.cos(heading - self.heading[j]) < 0:
            near = np.where(d <= d[j] + 3.0)[0]; agree = near[np.cos(heading - self.heading[near]) >= 0]
            if len(agree): j = int(agree[np.argmin(d[agree])])
        return j, float(d[j])
    def direction(self, idx, heading_rad):
        return 1 if math.cos(heading_rad - self.heading[idx]) >= 0 else -1

    def goal_ahead(self, idx, Ld, direction=1):
        """v15.3: the index Ld metres along the path AHEAD of idx in the direction of travel (wraps on a closed path;
        v15.6: CLAMPS to the last point of an open route -- the goal never comes round from the start)."""
        ds = self.ds_from(idx)
        if direction < 0: ds = -ds
        return int(np.argmin(np.abs(ds - Ld)))

    def to_body(self, gx, gz, ax, az, heading_rad):
        """v15.3: a path point -> the truck's body frame at the REAR AXLE, in `ground_point`'s convention:
        (right, forward) with RIGHT positive, so kappa = 2*right/d^2 keeps STANDING's sign rule (+ = steer right).
        The body forward axis is the look axis minus the mount yaw, the same axis `axle()` uses."""
        h = heading_rad - math.radians(self.mount_yaw)
        c, sn = math.cos(h), math.sin(h)
        dx, dz = gx - ax, gz - az
        return -dx * sn + dz * c, dx * c + dz * sn        # right = (f x up) on the floor = (-f_z, f_x); forward = along f

def return_kappa(tpath, pred, idx, direction, Ld, gain, kappa_max):
    """v15.3 -> (kappa, record) to steer the truck BACK onto the taught path, or (None, None) if the goal is degenerate.

    Pure pursuit at the REAR AXLE onto a point Ld metres along the reference ahead of the nearest one. Sign follows
    STANDING: + = steer right, so a truck LEFT of the path gets a POSITIVE curvature. Extracted from the loop so the
    bench can drive it (an offline test, not shipped)."""
    ax, az, h = pred
    gi = tpath.goal_ahead(idx, Ld, direction)
    gx, gz = float(tpath.xy[gi, 0]), float(tpath.xy[gi, 1])
    rx, fy = tpath.to_body(gx, gz, ax, az, h)
    d2 = rx * rx + fy * fy
    if d2 < 1e-6: return None, None
    k = max(-kappa_max, min(kappa_max, gain * 2.0 * rx / d2))
    return k, {"goal": [round(gx, 3), round(gz, 3)], "body": [round(rx, 3), round(fy, 3)],
               "kappa": round(k, 4), "behind": bool(fy < 0)}


def pure_pursuit_kappa(pts, Ld, fwd=0.0):
    """Standard pure pursuit at the goal point nearest the lookahead: kappa = 2x / d^2.
    2026-09-12 `fwd` (--cam-fwd): the derivation (Coulter 1992) takes (x, y) from the REAR AXLE; `ground_point` returns y
    from the LENS, which sits 0.24 m ahead of the axle (operator, tape, twice: wheelbase 0.28, lens 0.04 behind the front
    axle). Omitting it over-commands: replay of auto-boot-133556 (957 fresh model-steered moving frames) has 144 raw
    requests at full lock without the term and 0 with it; median |gain*kappa| 0.60 -> 0.33. The GOAL is still chosen
    by its distance from the lens (so --lookahead and --fit-max-y keep their meaning and the same row is aimed at);
    only the curvature is computed from the axle. fwd = 0 is byte-identical to before. The goal returned is (x, y_lens)."""
    if not pts: return None, None
    x, y = min(pts, key=lambda p: abs(math.hypot(p[0], p[1]) - Ld))
    ya = y + fwd
    d2 = x * x + ya * ya
    if d2 < 1e-6: return None, None
    return 2.0 * x / d2, (x, y)

# ---------------------------------------------------------------------------------------------
# 2a. Path curvature for the v8 feed-forward (2026-09-09). OFF unless --kff is passed.
#
# WHY A SEPARATE FIT AND NOT `pts`. `line_from_probs` applies the validated curvature CAP
# (0.05 patches/row^2): when the cubic and the quadratic both exceed it the fit falls back to a
# STRAIGHT LINE. Measured over the four kitchen-oval sessions with their leave-one-session-out
# heads, that fallback fires on 84-97 % of the frames whose path curvature is above 0.9 1/m --
# i.e. exactly the corner frames. The ground points the tool already computes are therefore
# straight to a median of 0.0 cm on a bend, and a curvature read off them is identically zero.
# The feed-forward instead re-fits the SAME per-row centroids the line is drawn from (`cent`,
# weighted by `mass`, gated by the same `conf`), before the cap. The pure-pursuit path is not
# touched: the line, the goal point and kappa = 2x/d^2 are byte for byte what they were.
# v9 NOTE: with --cap-kappa on, the line is no longer straight on most bend frames (10.8 % rather
# than 67.5 % on the oval, FINDINGS 39), so the two fits see much the same shape. The feed-forward
# still uses the raw centroids on purpose -- it must not inherit whatever the cap decides.
#
# WHY A WINDOWED QUADRATIC IN THE GROUND PLANE AND NOT A CIRCLE FIT. Curvature must be in 1/m in
# the ground frame, and `ground_point` maps rows to distances non-linearly, so image-space
# curvature is not proportional to it. Two ground-frame estimators were measured against the
# ARKit pose (the curvature of the path the truck actually drove, at the goal distance ahead):
#   * algebraic (Kasa) circle fit -- the near rows are packed into 0.30-0.60 m and are very close
#     to collinear, so the normal equations are near-singular; it returned |kappa| up to 2.4 1/m
#     on frames whose true curvature was zero (23-62 % of frames above 1.5 1/m). It reads noise as
#     curvature, which is the one failure that would wreck the straight. REJECTED.
#   * mass-weighted quadratic x = f(y) over a distance window, exact curvature
#     kappa = x'' / (1 + x'^2)^1.5 at the goal. Well conditioned, and the residual of the fit is
#     itself a usable quality gate. CHOSEN.
#
# WHY THE WINDOW. Past ~1.4x the lookahead the estimate REVERSES SIGN on a tight course: at 0.7 m
# bend radius the tape has already left the frame edge and the head locks onto the far side of the
# loop, which curves the other way. Opening the window to the whole band takes the correlation with
# pose from +0.72 to -0.5 and the sign agreement from 0.94 to 0.33. The window is expressed in
# multiples of the lookahead so it follows --lookahead / --look-trim.
#
# VALIDATED (2026-09-09, 2,468 moving frames, 4 oval sessions, LOSO heads, Ld 0.8):
#   r vs pose +0.72 | sign agreement in bends 0.94 | bend |kappa| p50 1.24 against a pose truth of
#   1.19 (ratio 1.04) | on straight frames p50 0.18, p90 0.43, max 1.02 | fires on 65 % of frames.
KFF_NEAR_FRAC, KFF_FAR_FRAC = 0.6, 1.4    # fit window, as multiples of the lookahead
KFF_MIN_PTS = 6                           # points needed inside the window (7 band rows land there
                                          # at Ld 0.8 wedge-up, so this is "6 of 7 rows confident")
KFF_MIN_SPAN = 0.25                       # m of forward span the window must actually cover
KFF_MAX_RESID = 0.02                      # m, mass-weighted rms residual of the quadratic

def path_curvature(rows, Ld, min_pts=KFF_MIN_PTS, max_resid=KFF_MAX_RESID):
    """Ground-frame curvature of the trail near the goal point -> (kappa 1/m, reason).

    `rows` is [(x right, y forward, mass)] for the confident band rows, ground-projected from the
    per-row centroids. kappa is positive when the trail curves RIGHT, the same convention as
    pure_pursuit_kappa. A non-None reason means NO estimate: the caller must then feed nothing
    forward, never a guess."""
    if Ld <= 0: return None, "no_look"
    lo, hi = KFF_NEAR_FRAC * Ld, KFF_FAR_FRAC * Ld
    P = [r for r in rows if lo <= r[1] <= hi]
    if len(P) < min_pts: return None, "few_pts"
    y = np.array([r[1] for r in P]); x = np.array([r[0] for r in P]); m = np.array([r[2] for r in P])
    if y.max() - y.min() < KFF_MIN_SPAN: return None, "short_span"
    if not np.isfinite(m).all() or m.sum() <= 0: return None, "no_mass"
    try:
        with warnings.catch_warnings():        # a rank-deficient frame is a "no estimate", not a
            warnings.simplefilter("ignore")    # message on a field console
            cf = np.polyfit(y, x, 2, w=np.sqrt(m))
    except Exception:
        return None, "fit_failed"
    if not np.isfinite(cf).all(): return None, "fit_failed"
    res = float(np.sqrt(np.average((np.polyval(cf, y) - x) ** 2, weights=m)))
    if not np.isfinite(res) or res > max_resid: return None, "resid"
    d1 = float(np.polyval(np.polyder(cf, 1), Ld)); d2 = 2.0 * float(cf[0])
    k = d2 / (1.0 + d1 * d1) ** 1.5
    if not np.isfinite(k): return None, "nan"
    return k, None

# ---------------------------------------------------------------------------------------------
# 3. Flight controller: the steering-channel override with the radio keeping everything else
# ---------------------------------------------------------------------------------------------
class FC:
    def __init__(self, port, sysid, steer_sign, cruise=False, recovery=False, heading=None, heading_receipt_path=None):
        launch_phase.before_fc_access()
        self.heading = heading
        from pymavlink import mavutil
        self.m = mavutil.mavlink_connection(port, baud=115200, source_system=sysid)
        if wait_rover_heartbeat(self.m) is None:
            sys.exit(f"REFUSING: no FC heartbeat on {port}")
        self.sign = steer_sign
        p = self._params(["MAV_GCS_SYSID", "SYSID_MYGCS", "RC_OVERRIDE_TIME",
                          "RC1_MIN", "RC1_TRIM", "RC1_MAX", "RC5_OPTION"])
        # Capture calibration on this connection, before the output owner exists.
        # Missing readbacks stay missing; a saved setup must not invent defaults.
        self.setup_parameters = dict(p)
        gcs = p.get("MAV_GCS_SYSID", p.get("SYSID_MYGCS"))
        # RC override is SILENTLY discarded from any other sysid (FINDINGS 16): no error, no motion.
        if gcs is None: sys.exit("REFUSING: could not read MAV_GCS_SYSID / SYSID_MYGCS")
        if int(gcs) != sysid:
            sys.exit(f"\nREFUSING TO COMMAND: FC expects GCS sysid {int(gcs)}, this sender is "
                     f"{sysid}. ArduPilot drops the override silently. Fix one side. FINDINGS 16.\n")
        self.rc_min, self.rc_trim, self.rc_max = int(p["RC1_MIN"]), int(p["RC1_TRIM"]), int(p["RC1_MAX"])
        self.override_time = float(p.get("RC_OVERRIDE_TIME", 3.0))
        print(f"FC ok: sysid gate {int(gcs)}; RC1 {self.rc_min}/{self.rc_trim}/{self.rc_max}; "
              f"RC_OVERRIDE_TIME {self.override_time}s; RC5_OPTION {int(p.get('RC5_OPTION', -1))} "
              f"(31 = killswitch); steer sign {steer_sign:+d} (higher PWM = right if +1)")
        # v6 cruise: the throttle channel's own neutral and dead zone, and a hard refusal if the
        # FC does not actually read throttle from the channel the tool overrides (RCMAP_THROTTLE 2), and
        # an override on the wrong channel is silent and wrong (arm_guard.py exists for this).
        self.thr_neutral, self.thr_dz, self.thr_ch = CRUISE_THR_NEUTRAL, CRUISE_THR_DZ, None
        if cruise:
            q = self._params(["RCMAP_THROTTLE", "RC2_TRIM", "RC2_DZ"])
            self.setup_parameters.update(q)
            self.thr_ch = int(q["RCMAP_THROTTLE"]) if "RCMAP_THROTTLE" in q else None
            if self.thr_ch != 2:
                sys.exit(f"\nREFUSING --cruise: RCMAP_THROTTLE reads {self.thr_ch}, not 2. This "
                         "tool overrides the RC throttle channel (RCMAP_THROTTLE 2); on any other mapping the "
                         "override is silently wrong. Fix the FC or drop --cruise. FINDINGS 30b.\n")
            if "RC2_TRIM" in q and 900 <= int(q["RC2_TRIM"]) <= 2100: self.thr_neutral = int(q["RC2_TRIM"])
            if "RC2_DZ" in q and int(q["RC2_DZ"]) > 0: self.thr_dz = int(q["RC2_DZ"])
            print(f"cruise: throttle is channel {self.thr_ch} (RCMAP_THROTTLE); "
                  f"RC2_TRIM {self.thr_neutral}, RC2_DZ {self.thr_dz}")
        self.recovery_profile = None
        self.recovery_parameters = None
        if recovery:
            self.recovery_parameters = self._params(REVERSE_PARAMETERS)
            try:
                self.recovery_profile = HardwareProfile.from_params(self.recovery_parameters)
            except ValueError as exc:
                self.m.close()
                sys.exit(f"REFUSING --stall-recovery: {exc}")
        setup_names = ["RCMAP_STEER", "RCMAP_THROTTLE", "RC1_DZ", "RC1_REVERSED",
                       "SERVO1_MIN", "SERVO1_TRIM", "SERVO1_MAX", "SERVO1_REVERSED", "SERVO1_FUNCTION",
                       "RC2_MIN", "RC2_TRIM", "RC2_MAX", "RC2_DZ", "RC2_REVERSED",
                       "SERVO3_MIN", "SERVO3_TRIM", "SERVO3_MAX", "SERVO3_REVERSED", "SERVO3_FUNCTION"]
        self.setup_parameters.update(self._params([name for name in setup_names if name not in self.setup_parameters]))
        for name in setup_names:
            self.setup_parameters.setdefault(name, None)
        # v3: ask for RC_CHANNELS + SERVO_OUTPUT_RAW at 20 Hz (ArduPilot's RC_CHANNELS stream
        # carries both). Heartbeat is 1 Hz on its own. Drained non-blocking once per frame.
        self.tele = {"rc1": None, "rc2": None, "rc3": None, "rc5": None, "rc6": None, "rc8": None, "gain_pwm": None, "look_pwm": None, "rc1_raw": None, "rssi": None,
                     "cruise_pwm": None, "rc2_stick": None,
                     "servo1": None, "servo3": None, "servo3_seq": 0, "mode": None, "armed": None,
                     "vbat": None, "ibat": None}     # v12.1 (2026-09-10): pack voltage (V) / current (A) from SYS_STATUS
        self._output_thread = None       # first sender owns all subsequent actuator writes
        self.tele_t = {"rc": 0.0, "servo": 0.0, "hb": 0.0}
        self.servo_stamp = None
        self.lock = threading.RLock()     # v5: the wheel forwarder polls/sends from its own thread
        for _ in range(3):
            self.m.mav.request_data_stream_send(self.m.target_system, self.m.target_component,
                                                mavutil.mavlink.MAV_DATA_STREAM_RC_CHANNELS, 50, 1)   # v5: 50 Hz so the wheel forwarder sees fresh stick values
        self.modes = {v: k for k, v in (self.m.mode_mapping() or {}).items()}
        self.heading_startup = None
        if heading is not None:
            # v12.1: SYS_STATUS (pack voltage/current) at 2 Hz. 2026-09-10 15:10: the truck could not hold cruise on a pack
            # the operator believed was full, and nothing in the log could say what the pack was doing.
            self.m.mav.request_data_stream_send(self.m.target_system, self.m.target_component,
                                                mavutil.mavlink.MAV_DATA_STREAM_EXTENDED_STATUS, 2, 1)
            from heading_telemetry import negotiate
            self.heading_startup = negotiate(self.m, self._ingest, heading_receipt_path, servo=recovery)
            print("heading startup:", self.heading_startup["status"], self.heading_startup["cadence"])
        else:
            # v4 test: RC_CHANNELS_RAW (msg 35) is not in any default stream -- ask for it at 20 Hz.
            self.m.mav.command_long_send(self.m.target_system, self.m.target_component,
                                         mavutil.mavlink.MAV_CMD_SET_MESSAGE_INTERVAL, 0, 35, 50000, 0, 0, 0, 0, 0)
            if recovery:
                self.m.mav.command_long_send(self.m.target_system, self.m.target_component,
                                             mavutil.mavlink.MAV_CMD_SET_MESSAGE_INTERVAL, 0, 36, 20000, 0, 0, 0, 0, 0)
            # v12.1: SYS_STATUS (pack voltage/current) at 2 Hz. 2026-09-10 15:10: the truck could not hold cruise on a pack
            # the operator believed was full, and nothing in the log could say what the pack was doing.
            self.m.mav.request_data_stream_send(self.m.target_system, self.m.target_component,
                                                mavutil.mavlink.MAV_DATA_STREAM_EXTENDED_STATUS, 2, 1)
    def poll(self, max_msgs=64):
        """Drain pending telemetry without blocking; return the latest values + their ages (ms)."""
        with self.lock: return self._poll(max_msgs)
    def _poll(self, max_msgs=64):
        for _ in range(max_msgs):
            r = self.m.recv_match(blocking=False)
            if r is None: break
            self._ingest(r, time.monotonic())
        now = time.monotonic()
        out = dict(self.tele)
        out["rc_age_ms"] = None if not self.tele_t["rc"] else round((now - self.tele_t["rc"]) * 1000)
        out["hb_age_ms"] = None if not self.tele_t["hb"] else round((now - self.tele_t["hb"]) * 1000)
        out["servo3_age_ms"] = None if not self.tele_t["servo"] else round((now - self.tele_t["servo"]) * 1000)
        out["rc1_steer_norm"] = None if out["rc1"] is None else round(self.steer_from_pwm(out["rc1"]), 4)
        return out
    def _ingest(self, r, now):
        t = r.get_type()
        if t == "RC_CHANNELS":
            self.tele.update(rc1=r.chan1_raw, rc2=r.chan2_raw, rc3=r.chan3_raw, rc5=r.chan5_raw,
                             rc6=r.chan6_raw, rc8=r.chan4_raw, gain_pwm=r.chan8_raw, look_pwm=r.chan7_raw, rssi=r.rssi,
                             cruise_pwm=r.chan9_raw, rc2_stick=r.chan10_raw)
            # "rc8" = the wheel copy (2026-09-07). gain_pwm = the gain trim x400.
            # v6: cruise_pwm = the speed dial x400 (the cruise level); rc2_stick = the trigger copy, the human's
            # REAL trigger -- the throttle channel itself reports OUR override once we send one, never the stick.
            self.tele_t["rc"] = now
        elif t == "RC_CHANNELS_RAW":      # v4 test: does this show the STICK while the steering channel is overridden?
            self.tele.update(rc1_raw=r.chan1_raw)
        elif (t == "SERVO_OUTPUT_RAW" and r.port == 0
              and r.get_srcSystem() == self.m.target_system
              and r.get_srcComponent() == self.m.target_component):
            # A repeated packet cannot fill a neutral dwell. Accept forward
            # uint32 source-time movement, including wrap, but not replay.
            delta = None if self.servo_stamp is None else (r.time_usec - self.servo_stamp) % (1 << 32)
            if delta is None or 0 < delta < (1 << 31):
                self.servo_stamp = r.time_usec
                self.tele.update(servo1=r.servo1_raw, servo3=r.servo3_raw,
                                 servo3_seq=self.tele["servo3_seq"] + 1)
                self.tele_t["servo"] = now
        elif (t == "ATTITUDE" and self.heading is not None
              and r.get_srcSystem() == self.m.target_system
              and r.get_srcComponent() == self.m.target_component):
            self.heading.ingest_attitude(r.time_boot_ms, now, r.roll, r.pitch, r.yaw,
                                         r.rollspeed, r.pitchspeed, r.yawspeed)
        elif t == "SYS_STATUS":           # v12.1: voltage_battery mV (65535 = none), current_battery cA (-1 = none)
            if 0 < r.voltage_battery < 65535: self.tele["vbat"] = round(r.voltage_battery / 1000.0, 2)
            if r.current_battery >= 0: self.tele["ibat"] = round(r.current_battery / 100.0, 1)
        elif t == "HEARTBEAT" and r.type != 6:            # 6 = GCS, ignore our own
            from pymavlink import mavutil
            self.tele.update(mode=self.modes.get(r.custom_mode, r.custom_mode),
                             armed=bool(r.base_mode & mavutil.mavlink.MAV_MODE_FLAG_SAFETY_ARMED))
            self.tele_t["hb"] = now
    def steer_from_pwm(self, pwm):
        """Inverse of pwm(): radio PWM -> steer_norm in the tool's convention (+ = right)."""
        if pwm >= self.rc_trim:
            f = (pwm - self.rc_trim) / max(1, self.rc_max - self.rc_trim)
        else:
            f = (pwm - self.rc_trim) / max(1, self.rc_trim - self.rc_min)
        return max(-1.0, min(1.0, f)) * self.sign
    def _params(self, names):
        got = {}
        for name in names:
            self.m.mav.param_request_read_send(self.m.target_system, self.m.target_component, name.encode(), -1)
            t0 = time.monotonic()
            while time.monotonic() - t0 < 1.5:
                r = self.m.recv_match(type="PARAM_VALUE", blocking=True, timeout=0.5)
                if r and r.param_id == name: got[name] = r.param_value; break
        return got
    def pwm(self, steer_norm):
        f = max(-1.0, min(1.0, steer_norm)) * self.sign
        span = (self.rc_max - self.rc_trim) if f >= 0 else (self.rc_trim - self.rc_min)
        return int(round(self.rc_trim + f * span))
    def send(self, pwm, thr):
        """Explicit channel pair; no cached throttle. Only the output thread may send."""
        with self.lock:
            thread = threading.get_ident()
            if self._output_thread is None: self._output_thread = thread
            if self._output_thread != thread: raise RuntimeError("actuator write outside output owner")
            self.m.mav.rc_channels_override_send(self.m.target_system, self.m.target_component,
                                                 int(pwm), int(thr), 0, 0, 0, 0, 0, 0)
    def release(self, n=20):
        for _ in range(n):
            self.send(0, 0)
            time.sleep(0.02)

# ---------------------------------------------------------------------------------------------
# 3a. Cruise throttle (v6, 2026-09-08): hold a fixed throttle on the throttle channel so a tuning pass is one
# cell and not also a hand-throttle (ANALYSIS-2026-09-08-tuning-process 6B, 9).
#
# THE HUMAN ALWAYS WINS. The trigger is read from the trigger copy, a radio mixer copy of the throttle channel -- NOT from it
# itself, because once the tool overrides a channel ArduPilot's RC_CHANNELS reports the OVERRIDE
# on it, not the stick (the same trap the wheel copy solves for steering). Any movement of the
# real trigger, FORWARD OR BRAKE/REVERSE, is |stick - neutral| > band and drops cruise on that
# frame; the tool then sends 0 on the throttle channel and the FC hands throttle back to the receiver, which
# is already carrying the human's demand, so the very pull that broke the neutral band is what
# drives the truck. A brake pull is the same path and is not slowed by cruise for even one frame.
# If the trigger copy is not mapped, unreadable or out of range, cruise NEVER engages -- with no view of the
# real trigger the tool cannot know whether the human is asking for anything.
# ---------------------------------------------------------------------------------------------
def brake_latch_update(latched, stick, hold_sw, thr_neutral, band):
    """v13d (2026-09-12 09:50, the reverse finding): a brake/reverse pull LATCHES cruise off; the latch clears on a FORWARD
    trigger pull or the HOLD switch. Without it cruise re-engaged the instant the trigger returned to neutral between the
    XL-5's two reverse taps, so the ESC saw forward, never neutral, and reverse almost never engaged (run 091339, 69 pulls)."""
    if stick is None: return latched
    if stick < thr_neutral - band: return True
    if stick > thr_neutral + band or hold_sw: return False
    return latched

def cruise_setpoint_mps(a, ch9):
    """v15.2 -> the SPEED setpoint the dial is asking for (m/s), or None when --cruise-mps is off / the dial is
    at its bottom tenth (= stopped, the trigger owns throttle). Pure, so the decider and the loop agree."""
    mps = getattr(a, "cruise_mps", None)
    if not mps or not ch9 or not (900 <= ch9 <= 2100) or ch9 <= 1100: return None
    lo, hi = float(mps[0]), float(mps[1])
    return lo + (min(ch9, 2000) - 1100) / 900.0 * (hi - lo)


class CruiseSpeedLoop:
    """v15.2: hold a commanded m/s by trimming the cruise PWM, from the phone's 15 Hz pose speed.

    out = clamp(feed_forward(setpoint) + Kp*e + I),  e = setpoint - v,  I integrated at Ki with conditional
    integration (the integral only moves while the output is off its limits, or while it is unwinding).

    SAFETY. The loop can only ever move the throttle inside [lo, hi] = [the band floor, --cruise-max], which are
    the same limits a dialled PWM obeys; it never reverses and never exceeds the ceiling. With NO usable pose it
    HOLDS the last output and freezes the integrator -- it never ramps blind, because the one failure that matters
    is a stale speed reading being read as "too slow" (FINDINGS 67: a wound-up throttle in a bend is a crash).
    Disengaging cruise resets it, so the truck cannot come back with a wound-up integrator."""

    def __init__(self, a, lo_pwm, hi_pwm):
        self.a = a; self.lo = float(lo_pwm); self.hi = float(hi_pwm); self._output_epoch = None; self.reset()

    def reset(self):
        self.i = 0.0; self.t = None; self.out = None
        self.launch_reset_pending = bool(getattr(self.a, "cruise_launch_reset", False))

    def reset_for_epoch(self, epoch):
        """The sender can disengage and rearm while the camera loop is frozen."""
        if epoch != self._output_epoch:
            self.reset(); self._output_epoch = epoch

    def update(self, ff_pwm, sp, v, v_age_ms, now, engaged):
        """-> (pwm, record dict or None). `ff_pwm` is cruise_decide's feed-forward level."""
        if not engaged or sp is None or sp <= 0.02:
            self.reset(); return ff_pwm, None
        dt = 0.0 if self.t is None else max(0.0, min(0.5, now - self.t)); self.t = now
        why = None
        if v is None: why = "no_pose"
        elif v_age_ms is None or v_age_ms > self.a.pose_max_age_ms: why = "pose_stale"
        if why is not None:                                            # HOLD, never ramp blind
            out = self.out if self.out is not None else float(ff_pwm)
            return int(round(out)), dict(sp=round(sp, 3), v=None, i=round(self.i, 1), ff=int(ff_pwm),
                                         out=int(round(out)), why=why)
        # Optional experiment: shed break-away trim once motion is observed. The
        # existing engagement/owner epoch resets rearm this; a later slowdown or
        # battery sag must not discard the ordinary integral again. Consume even
        # when I <= 0, and keep negative trim. Missing/stale pose returned above.
        launch_reset = False; removed_i = 0.0
        launch_threshold = min(0.10, sp * 0.5)
        if self.launch_reset_pending and v >= launch_threshold:
            removed_i = max(0.0, self.i)
            self.i -= removed_i
            self.launch_reset_pending = False
            launch_reset = True
        e = sp - v
        i_try = max(-self.a.cruise_i_max, min(self.a.cruise_i_max, self.i + self.a.cruise_ki * e * dt))
        raw = ff_pwm + self.a.cruise_kp * e + i_try
        if self.lo < raw < self.hi or (raw >= self.hi and e < 0) or (raw <= self.lo and e > 0):
            self.i = i_try                                             # conditional integration (anti-windup)
        out = max(self.lo, min(self.hi, ff_pwm + self.a.cruise_kp * e + self.i))
        self.out = out
        record = dict(sp=round(sp, 3), v=round(v, 3), e=round(e, 3), i=round(self.i, 1),
                      ff=int(ff_pwm), out=int(round(out)), why=None)
        if getattr(self.a, "cruise_launch_reset", False):
            record["launch_reset"] = dict(threshold_mps=round(launch_threshold, 4),
                                          triggered=launch_reset, removed_i_us=round(removed_i, 1),
                                          pending=self.launch_reset_pending)
        return int(round(out)), record


def cruise_decide(a, tele, hold_sw, thr_neutral=CRUISE_THR_NEUTRAL, thr_dz=CRUISE_THR_DZ, brake_latched=False):
    """-> (level_pwm or None, reason or None). reason None = cruise is ENGAGED this frame.

    `level_pwm` is what the flags/trim ASK for (logged even when disengaged, so a log says what
    the pass was set to); it is only commanded when reason is None. Every condition here is a
    veto: the first one that fails disengages, and the caller then sends 0 on the throttle channel."""
    if not getattr(a, "cruise", False): return None, "off"
    if tele is None: return None, "no_fc"
    band = max(thr_dz, CRUISE_MIN_BAND)
    ceiling = min(int(a.cruise_max), CRUISE_ABS_MAX)

    # the commanded level: live from the speed dial, or the fixed --cruise-pwm
    if a.cruise_trim:
        ch9 = tele.get("cruise_pwm")
        if not ch9 or not (900 <= ch9 <= 2100): return None, "no_ch9"
        mps = getattr(a, "cruise_mps", None)
        band_us = getattr(a, "cruise_band", None)
        if mps:
            # v15.2: the dial is a SPEED. `level` here is only the FEED-FORWARD guess for that speed, so that every
            # veto below (above all "stopped") behaves exactly as it does for a dialled PWM; the PI trim is applied
            # by the caller, which alone can see the pose. Dial at the bottom = stopped = the trigger owns throttle.
            sp = cruise_setpoint_mps(a, ch9)
            level = thr_neutral if not sp else int(round(CRUISE_FF_US + CRUISE_US_PER_MPS * sp))
        elif band_us:
            # v15.1 (operator, 2026-09-13 14:0x, "a consistent cruise for the rest of the testing"): the speed dial is the CRUISE DIAL over a NARROW band.
            # The bottom tenth of the trim (<= 1100) = STOPPED = the receiver owns throttle (your trigger); the rest maps linearly
            # LO..HI us, so at 1625..1725 one trim click (~65 us on the channel) is ~7 us of throttle instead of 16. Absent = the v6 formula.
            lo, hi = int(band_us[0]), int(band_us[1])
            level = thr_neutral if ch9 <= 1100 else int(round(lo + (min(ch9, 2000) - 1100) / 900.0 * (hi - lo)))
        else:
            level = int(round(thr_neutral + (ch9 - 1000) / 1000.0 * CRUISE_SPAN_US))
    else:
        level = int(a.cruise_pwm)
    level = max(thr_neutral, min(ceiling, level))      # never above the ceiling, never in reverse

    # RC telemetry must be fresh: a stale RC_CHANNELS means we cannot see the trigger or the switch
    age = tele.get("rc_age_ms")
    if age is None or age > CRUISE_RC_MAX_AGE_MS: return level, "rc_stale"
    # trim wound down to its minimum = STOPPED, the always-available way to disarm cruise
    if level <= thr_neutral + band: return level, "stopped"
    # the real trigger, from the trigger mixer copy -- forward OR brake/reverse hands throttle back
    stick = tele.get("rc2_stick")
    if not stick or not (900 <= stick <= 2100): return level, "no_ch10"
    if abs(stick - thr_neutral) > band: return level, "human_trigger"
    if brake_latched: return level, "post_brake"       # v13d: a brake pull holds cruise off until a forward pull / HOLD
    if hold_sw: return level, "hold_sw"                # mode switch at the HOLD end: the FC's own stop
    if tele.get("mode") != "MANUAL": return level, "mode"
    if not tele.get("armed"): return level, "disarmed"
    return level, None

# ---------------------------------------------------------------------------------------------
# Independent output: output_owner.py owns both channels. Preserve this wheel
# policy as a pure helper; the sender applies it from the freshly polled physical wheel copy.
# ---------------------------------------------------------------------------------------------
def override_weight(wheel, now, last_touch, dz, hold_ms):
    """v13d OVERRIDE (operator's ruling 2026-09-12 09:35): the steering head steers until the human touches the wheel; then the wheel
    steers ENTIRELY; the steering head gets the servo back --override-hold-ms after the wheel returns inside its deadband.
    Returns (w, last_touch): w = 1.0 model / 0.0 wheel (the blend's own convention), last_touch = time of the last touch."""
    if abs(wheel) > dz: last_touch = now
    w = 0.0 if (now - last_touch) * 1000.0 < hold_ms else 1.0
    return w, last_touch

# ---------------------------------------------------------------------------------------------
# 3b. Recording off the control path (external review 2026-09-13, verified in our own logs).
#
# Until this date the frame loop wrote the jsonl line, two JPEGs and -- every 500 frames -- np.savez_compressed of the
# WHOLE probability history, inline. The checkpoint interval grew with run length (102 ms at frame 500, 1,034 ms at
# 11,500) and past ~frame 5,000 it exceeded the wheel forwarder's --hold-ms 500 watchdog, which then substituted ZERO
# steering: 215204 frame 7000 -> 7001, dt 650 ms, servo 1811 -> 1463 us at full lock at 0.56 m/s. Every run over ~5.5 min
# on 2026-09-12 had its steering centred for a beat every 33 s. The per-frame `ms` never showed it (measured before the writes).
#
# Now: ONE bounded queue and one writer thread. The loop hands over the line, the arrays and the images and never
# touches the disk. Probabilities go out in fixed-size CHUNKS (probs_chunk_NNNN.npz, PROBS_CHUNK frames each) and are
# merged into probs.npz at exit, off the control path; a hard power-off leaves the chunks, which replay_fit_sweep.py
# reads directly. If the writer falls behind the queue fills and items are DROPPED and counted (rec["rec_dropped"]),
# never queued without bound and never allowed to block steering. The watchdog is unchanged.
# ---------------------------------------------------------------------------------------------
PROBS_CHUNK = 500
class LogWriter(threading.Thread):
    """Two queues: ESSENTIAL (jsonl lines, probability chunks, close) is never dropped -- it is ~1 KB per frame and a
    chunk per 500, so a stalled disk grows it slowly and boundedly by run length; IMAGES (feed + stills) are the only
    thing that may be dropped, and are, with a count, once their queue holds `img_max` of them."""
    def __init__(self, logdir, jsonl, img_max=64):
        super().__init__(daemon=True)
        self.logdir = Path(logdir); self.f = jsonl
        self.q = queue.Queue(); self.qimg = queue.Queue(maxsize=img_max)
        self.dropped = 0; self.written = 0; self.chunks = 0; self.err = None
        self.last_sync = 0.
    def put(self, kind, *args):
        if kind == "jpg":
            try: self.qimg.put_nowait(args)
            except queue.Full: self.dropped += 1
        else: self.q.put((kind, args))
    def qsize(self): return self.q.qsize() + self.qimg.qsize()
    def _do(self, kind, args):
        import cv2
        try:
            if kind == "line":
                self.f.write(args[0]); self.f.flush()
                if time.monotonic() - self.last_sync >= 1.:
                    os.fsync(self.f.fileno()); self.last_sync = time.monotonic()
            elif kind == "jpg": cv2.imwrite(str(args[0]), args[1], [cv2.IMWRITE_JPEG_QUALITY, args[2]])
            elif kind == "rm":
                try: Path(args[0]).unlink()
                except FileNotFoundError: pass
            elif kind == "chunk":
                k, probs, danger = args
                from durable_run import atomic_npz
                atomic_npz(self.logdir / f"probs_chunk_{k:04d}.npz", probs=np.stack(probs),
                                    danger=np.stack(danger) if danger else np.zeros((0,)))
                self.chunks += 1
            elif kind == "sweep-checkpoint":
                from durable_run import atomic_json
                self.f.flush(); os.fsync(self.f.fileno())
                atomic_json(self.logdir / "sweep-progress.json", args[0])
            elif kind == "setup-observation":
                observer, snapshot, frame, final = args
                observer(self.logdir, snapshot, frame=frame, final=final)
            self.written += 1
        except Exception as e:
            self.err = repr(e)
    def run(self):
        closing = False
        while True:
            try:
                kind, args = self.q.get_nowait()          # essential first, always
                if kind == "close": closing = True
                else: self._do(kind, args); continue
            except queue.Empty:
                pass
            if closing and self.q.empty():
                while not self.qimg.empty():              # drain whatever images are left, then go
                    self._do("jpg", self.qimg.get_nowait())
                self.f.flush(); os.fsync(self.f.fileno()); self.f.close(); return
            try: self._do("jpg", self.qimg.get(timeout=0.05))
            except queue.Empty: pass
    def close(self, timeout=60.0):
        self.put("close"); self.join(timeout)
def merge_probs_chunks(logdir, NR, GW):
    """probs_chunk_*.npz -> probs.npz (same layout as before the writer), at exit and off the control path."""
    logdir = Path(logdir); files = sorted(glob.glob(str(logdir / "probs_chunk_*.npz")))
    chunks, dang = [], []
    for f in files:
        with np.load(f) as z:
            chunks.append(z["probs"])
            if z["danger"].size: dang.append(z["danger"])
    probs = np.concatenate(chunks) if chunks else np.zeros((0, NR, GW), np.float16)
    from durable_run import atomic_npz
    atomic_npz(logdir / "probs.npz", probs=probs, danger=np.concatenate(dang) if dang else np.zeros((0,)))
    # Keep completed chunks: they are independent recovery/offload units.
    return probs.shape[0], len(files)

# ---------------------------------------------------------------------------------------------
# 4. Frame sources: Moblin over iproxy (live) or a corpus rgb.mp4 (identical downstream path)
# ---------------------------------------------------------------------------------------------
def rd(s, n):
    b = bytearray()
    while len(b) < n:
        c = s.recv(n - len(b))
        if not c: return None
        b += c
    return bytes(b)

def msg(s):
    h = rd(s, 5)
    if h is None: return None, None
    t, ln = struct.unpack(">BI", h)
    return t, (rd(s, ln) if ln else b"")

def params_from(rec, codec):
    out = b""
    if codec == 0:                                    # avcC
        n = rec[5] & 0x1F; i = 6
        for _ in range(n):
            L = struct.unpack(">H", rec[i:i+2])[0]; i += 2; out += SC + rec[i:i+L]; i += L
        npps = rec[i]; i += 1
        for _ in range(npps):
            L = struct.unpack(">H", rec[i:i+2])[0]; i += 2; out += SC + rec[i:i+L]; i += L
        return out, (rec[4] & 3) + 1
    nls = (rec[21] & 3) + 1; na = rec[22]; i = 23     # hvcC
    for _ in range(na):
        i += 1
        cnt = struct.unpack(">H", rec[i:i+2])[0]; i += 2
        for _ in range(cnt):
            L = struct.unpack(">H", rec[i:i+2])[0]; i += 2; out += SC + rec[i:i+L]; i += L
    return out, nls

def moblin_frames(port, secs, ingest="async"):
    """--ingest async (default since 2026-09-13, external review step 3): reception and decoding run continuously in
    their own threads, independent of the perception loop; the loop wakes when a decoded frame is available and takes the
    NEWEST one (older undelivered frames are skipped and counted). Each image carries its own stamps: pts (the phone's
    capture clock, via the FIFO), t_rx (packet received), t_dec (out of ffmpeg), and the loop adds t_take. Before this,
    the loop read one packet per iteration and only then picked up whatever ffmpeg had finished -- up to one 66.7 ms
    frame period of avoidable age, and a packet backlog whenever inference ran long. Nothing about geometry, the perception model or
    steering changes. `PHONE[...]` is written from the taken snapshot at yield time, never from the reader threads."""
    if ingest == "sync":
        yield from moblin_frames_sync(port, secs); return
    s = socket.create_connection(("127.0.0.1", port), timeout=15)
    s.sendall(struct.pack(">BIB", HOST_HELLO, 1, 1)); HOST_SOCK[0] = s
    print("connected to Moblin (async ingest); waiting for videoConfig ...")
    cond = threading.Condition(); slot = {"img": None, "pts": None, "depth": None, "t_rx": None, "t_dec": None, "seq": 0,
                                          "pts_rx": None, "dead": None}
    pending = deque()                                 # (pts_us, t_rx) of access units written to ffmpeg, oldest first
    def _die(why):
        with cond: slot["dead"] = why; cond.notify_all()
    def _reader():
        dec = None; nls = 4; W = H = None
        cur = [None]                                  # the decoder that is live; a retired one's drain must not kill the run
        try:
            while True:
                t, p = msg(s)
                if t is None: _die("stream closed"); return
                if t == DEVICE_HELLO:
                    try:
                        PHONE["hello"] = json.loads(p[5:5 + struct.unpack(">I", p[1:5])[0]])
                        h = PHONE["hello"]; off = h.get("utc_s", 0) - time.time()
                        print(f"hello: {h.get('name')} {h.get('app', '')} {h.get('app_version', h.get('version'))} pitch={h.get('pitch_deg')} "
                              f"disk={h.get('disk_free_mb')}MB recording={h.get('recording')} phone-Orin clock offset {off:+.1f} s")
                    except Exception as e: print(f"hello: unreadable ({e})")
                elif t == STATUS:
                    try:
                        PHONE["status"] = json.loads(p); PHONE["status_t"] = time.monotonic(); note_pose(PHONE["status"])
                        u = PHONE["status"].get("utc_s")
                        if isinstance(u, (int, float)):
                            PHONE["clock_offs"].append(u - time.time()); PHONE["clock_off"] = max(PHONE["clock_offs"])
                    except Exception: pass
                elif t == VIDEO_CONFIG:
                    codec = p[0]; W, H = struct.unpack(">HH", p[1:5]); ln = struct.unpack(">I", p[5:9])[0]
                    PHONE["video_config"] = {"width": W, "height": H, "codec": codec, "received_epoch": time.time()}
                    params, nls = params_from(p[9:9+ln], codec)
                    print(f"codec={'H264' if codec == 0 else 'HEVC'} {W}x{H}")
                    if W * 3 != H * 4:   # 2026-10-03 00:0x (operator): any 4:3 size is the same field of view block-meaned on the phone; the feed is a resize of the whole frame
                        print(f"REFUSING: stream is {W}x{H}, not 4:3 (corpus geometry {SRC_W}x{SRC_H}). "
                              f"Set Moblin to 1440p (4:3) and verify from the wire (FINDINGS 20)."); _die("geometry"); return
                    if (W, H) != (SRC_W, SRC_H): print(f"stream {W}x{H}: 4:3 at 1/{SRC_W // W}, resized to the {FEED_W}x{FEED_H} feed as the full frame would be")
                    if dec is not None:
                        # 2026-10-02: since robot-eyes ticket 10 the phone sends a videoConfig every time its Record view
                        # reopens (the host keeps its connection). Retire the old ffmpeg instead of leaking one per reopen.
                        old, dec = dec, None; cur[0] = None   # cur first: the old drain thread wakes on the kill and must see it is retired
                        with cond: pending.clear()            # stamps of frames the old decoder never emitted: left in, every frame after the reopen takes the stamp of the one before it (Orin + Mac, 2026-10-02 19:1x)
                        try: old.stdin.close()
                        except Exception: pass
                        old.kill()
                        try: old.wait(timeout=2)              # reap it, or pgrep/ps keep showing a zombie decoder
                        except Exception: pass
                    fb = W * H * 3
                    # 2026-09-13 step 4a tried NVIDIA's hardware decoder (hevc_nvv4l2dec through ffmpeg) and WITHDREW it the same night:
                    # by picture COUNT it holds one frame, but by picture CONTENT it delivers 1-13 frames of older material from its
                    # output pool (FINDINGS 58 erratum, dec_content.py on the real stream). Software -threads 2 has zero content lag and,
                    # with the boundary NAL + probe flags below, 93 ms median fed->picture (was 160). hw is kept for A/B only.
                    dcodec = (["-c:v", "hevc_nvv4l2dec" if codec else "h264_nvv4l2dec"] if DECODER[0] == "hw" else ["-threads", "1"])
                    # 2026-09-13: -probesize 32 -analyzeduration 0 -- ffmpeg's stream probe held ~80-129 access units (5.3-8.7 s) before
                    # the first picture; the params are in-band and the geometry is checked above, so nothing needs probing. Benched on the
                    # real stream: first frame after 6 AUs instead of 79, and the per-frame tail is gone (aud path p90 27.6, max 28.9 ms).
                    # -fflags nobuffer / -flags low_delay were tried and made the hardware path WORSE (93 ms, one frame held): leave them out.
                    dec = subprocess.Popen(
                        ["ffmpeg", "-loglevel", "quiet", "-probesize", "32", "-analyzeduration", "0", *dcodec,
                         "-f", "hevc" if codec else "h264", "-i", "pipe:0",
                         "-f", "rawvideo", "-pix_fmt", "bgr24", "pipe:1"],
                        stdin=subprocess.PIPE, stdout=subprocess.PIPE)
                    dec.stdin.write(params); dec.stdin.flush(); cur[0] = dec
                    def _drain(fh=dec.stdout, fb=fb, H=H, W=W, proc=dec):
                        while True:
                            raw = fh.read(fb)
                            if not raw or len(raw) < fb:
                                if proc is cur[0]: _die("decoder ended")   # a retired decoder ending is expected
                                return
                            if proc is not cur[0]: return     # a frame the kill flushed out of the retired decoder: drop it, its stamp is gone
                            a_ = np.frombuffer(raw, np.uint8).reshape(H, W, 3); t_dec = time.monotonic()
                            with cond:                # one decoded frame per access unit, in order: take the oldest stamp
                                pts, t_rx = pending.popleft() if pending else (None, None)
                                slot.update(img=a_, pts=pts, depth=len(pending), t_rx=t_rx, t_dec=t_dec, seq=slot["seq"] + 1)
                                cond.notify()
                    threading.Thread(target=_drain, daemon=True).start()
                elif t == VIDEO_FRAME and dec:
                    pts_rx = struct.unpack(">Q", p[:8])[0]; t_rx = time.monotonic()
                    au = p[9:]; buf = bytearray(); i = 0
                    while i + nls <= len(au):
                        L = int.from_bytes(au[i:i+nls], "big"); i += nls
                        buf += SC + au[i:i+L]; i += L
                    if AU_DELIM[0]: buf += AU_END_HEVC if codec else AU_END_H264   # end this AU now, do not wait for the next one
                    with cond:
                        pending.append((pts_rx, t_rx)); slot["pts_rx"] = pts_rx
                        if len(pending) > DEC_MAX_DEPTH:
                            while len(pending) > DEC_MAX_DEPTH: pending.popleft()
                            PHONE["dec_desync"] += 1
                    try: dec.stdin.write(bytes(buf)); dec.stdin.flush()
                    except BrokenPipeError: _die("decoder died"); return
        except Exception as e:
            _die(f"reader error: {e!r}")
    threading.Thread(target=_reader, daemon=True).start()
    t_end = time.monotonic() + secs if secs else None; last = 0
    while t_end is None or time.monotonic() < t_end:
        with cond:
            while slot["seq"] == last and slot["dead"] is None:
                if not cond.wait(timeout=1.0) and t_end is not None and time.monotonic() >= t_end: break
            if slot["dead"] is not None and slot["seq"] == last: print(slot["dead"]); return
            if slot["seq"] == last: continue
            img, pts, depth, t_rx, t_dec, seq, pts_rx = (slot["img"], slot["pts"], slot["depth"], slot["t_rx"], slot["t_dec"],
                                                        slot["seq"], slot["pts_rx"])
        PHONE["pts_us"], PHONE["dec_depth"], PHONE["pts_rx_us"] = pts, depth, pts_rx
        PHONE["t_rx"], PHONE["t_dec"], PHONE["t_take"], PHONE["skipped"] = t_rx, t_dec, time.monotonic(), seq - last - 1
        last = seq
        yield img

def moblin_frames_sync(port, secs):
    """The pre-2026-09-13 reader (--ingest sync): one packet per loop iteration, the decoded frame picked up only when the
    next packet arrives. Kept for A/B. Yields full-resolution BGR frames (SRC_H, SRC_W, 3), the freshest available."""
    s = socket.create_connection(("127.0.0.1", port), timeout=15)
    s.sendall(struct.pack(">BIB", HOST_HELLO, 1, 1)); HOST_SOCK[0] = s
    print("connected to Moblin; waiting for videoConfig ...")
    frames = deque(maxlen=2); qlock = threading.Lock(); dec = None; nls = 4
    pending = deque()                                 # pts_us of access units written to ffmpeg, oldest first
    W = H = None; frame_bytes = None; t_end = time.monotonic() + secs if secs else None
    while t_end is None or time.monotonic() < t_end:
        t, p = msg(s)
        if t is None: print("stream closed"); return
        if t == DEVICE_HELLO:
            try:
                PHONE["hello"] = json.loads(p[5:5 + struct.unpack(">I", p[1:5])[0]])
                h = PHONE["hello"]; off = h.get("utc_s", 0) - time.time()
                print(f"hello: {h.get('name')} {h.get('app', '')} {h.get('app_version', h.get('version'))} pitch={h.get('pitch_deg')} "
                      f"disk={h.get('disk_free_mb')}MB recording={h.get('recording')} phone-Orin clock offset {off:+.1f} s")
            except Exception as e: print(f"hello: unreadable ({e})")
        elif t == STATUS:
            try:
                PHONE["status"] = json.loads(p); PHONE["status_t"] = time.monotonic(); note_pose(PHONE["status"])
                u = PHONE["status"].get("utc_s")
                if isinstance(u, (int, float)):           # phone minus Orin; transport delay only lowers it, so keep the max of a window
                    PHONE["clock_offs"].append(u - time.time()); PHONE["clock_off"] = max(PHONE["clock_offs"])
            except Exception: pass
        elif t == VIDEO_CONFIG:
            codec = p[0]; W, H = struct.unpack(">HH", p[1:5]); ln = struct.unpack(">I", p[5:9])[0]
            PHONE["video_config"] = {"width": W, "height": H, "codec": codec, "received_epoch": time.time()}
            params, nls = params_from(p[9:9+ln], codec)
            print(f"codec={'H264' if codec == 0 else 'HEVC'} {W}x{H}")
            if W * 3 != H * 4:
                print(f"REFUSING: stream is {W}x{H}, not 4:3 (corpus geometry {SRC_W}x{SRC_H}). "
                      f"Set Moblin to 1440p (4:3) and verify from the wire (FINDINGS 20)."); return
            if dec is not None:                           # 2026-10-02: one videoConfig per Record-view reopen (robot-eyes ticket 10); retire, do not leak
                old, dec = dec, None
                with qlock: pending.clear()               # see moblin_frames: the retired decoder's unemitted stamps would mis-tag every later frame
                try: old.stdin.close()
                except Exception: pass
                old.kill()
                try: old.wait(timeout=2)
                except Exception: pass
            frame_bytes = W * H * 3
            dec = subprocess.Popen(
                # 2026-09-12 (operator's ruling after FINDINGS 54): -threads 2. ffmpeg's default frame-threading across the 6
                # cores held 7 decoded-but-unreleased frames = 533 ms of stale image (dec_depth in frames.jsonl). Real 1440p
                # 8 Mbit HEVC on the Orin: auto 55 fps / 7 frames; 2 threads 28 fps / ~1-2 frames; 1 thread 18 fps, too close
                # to the 15 fps stream beside the perception model's 45 ms. Expect dec_depth 1-2 and capture->record ~200-250 ms.
                ["ffmpeg", "-loglevel", "quiet", "-probesize", "32", "-analyzeduration", "0", "-threads", "2",
                 "-f", "hevc" if codec else "h264", "-i", "pipe:0",
                 "-f", "rawvideo", "-pix_fmt", "bgr24", "pipe:1"],
                stdin=subprocess.PIPE, stdout=subprocess.PIPE)
            dec.stdin.write(params); dec.stdin.flush()
            def _drain(fh=dec.stdout, fb=frame_bytes):
                while True:
                    raw = fh.read(fb)
                    if not raw or len(raw) < fb: return
                    a_ = np.frombuffer(raw, np.uint8).reshape(H, W, 3)
                    with qlock:                       # one decoded frame per access unit, in order: take the oldest stamp
                        pts = pending.popleft() if pending else None
                        frames.append((a_, pts, len(pending)))
            threading.Thread(target=_drain, daemon=True).start()
        elif t == VIDEO_FRAME and dec:
            pts_rx = struct.unpack(">Q", p[:8])[0]
            au = p[9:]; buf = bytearray(); i = 0
            while i + nls <= len(au):
                L = int.from_bytes(au[i:i+nls], "big"); i += nls
                buf += SC + au[i:i+L]; i += L
            if AU_DELIM[0]: buf += AU_END_HEVC if codec else AU_END_H264
            with qlock:
                pending.append(pts_rx)
                if len(pending) > DEC_MAX_DEPTH:      # the decoder swallowed an access unit: drop the stale head, count it
                    while len(pending) > DEC_MAX_DEPTH: pending.popleft()
                    PHONE["dec_desync"] += 1
            try: dec.stdin.write(bytes(buf)); dec.stdin.flush()
            except BrokenPipeError: print("decoder died"); return
            with qlock:
                item = frames.pop() if frames else None; frames.clear()
            if item is not None:
                img, PHONE["pts_us"], PHONE["dec_depth"] = item
                PHONE["pts_rx_us"] = pts_rx
                yield img

def video_frames(path, start, step, secs, fps=0.0):
    """fps > 0 paces playback to that many SOURCE frames per second (corpus is 5 fps), so the
    wheels move at the trail's real tempo when --fc is attached."""
    import cv2
    cap = cv2.VideoCapture(str(path)); fi = 0
    if start: cap.set(cv2.CAP_PROP_POS_FRAMES, start); fi = start
    t_end = time.monotonic() + secs if secs else None; t_start = time.monotonic()
    while t_end is None or time.monotonic() < t_end:
        ok, fr = cap.read()
        if not ok: return
        if (fi - start) % step == 0:
            if fps > 0:
                due = t_start + (fi - start) / fps
                if due > time.monotonic(): time.sleep(due - time.monotonic())
            yield fr
        fi += 1

class RelayLink:
    """Stage 4 (2026-09-30): the latest datagram from a control_cmd relay (not shipped), read on its own thread.
    No ROS in this process. Holds ONE value; the loop reads it with age so a dead relay is visible as staleness,
    never as a held command."""
    def __init__(self, port, sign):
        import socket, threading
        self.sign = sign; self.n = 0; self.bad = 0; self._lock = threading.Lock(); self._last = None; self._t = None
        self.sock = socket.socket(socket.AF_INET, socket.SOCK_DGRAM)
        self.sock.bind(("127.0.0.1", port)); self.sock.settimeout(0.5)
        threading.Thread(target=self._reader, daemon=True, name="relay-udp").start()
        print(f"relay link: udp 127.0.0.1:{port}, sign {sign:+g} (truck = sign x planner)")

    def _reader(self):
        import socket as _s
        while True:
            try: data, _ = self.sock.recvfrom(4096)
            except _s.timeout: continue
            except OSError: return
            try:
                d = json.loads(data.decode()); k = float(d["k"])
                if not math.isfinite(k): raise ValueError("k not finite")
                rec = {"seq": int(d.get("seq", 0)), "k": self.sign * k, "ls": bool(d.get("ls", False)),
                       "v": float(d.get("v", 0.0))}
            except Exception:
                self.bad += 1; continue
            with self._lock:
                self._last = rec; self._t = time.monotonic(); self.n += 1

    def latest(self, now, max_age_ms):
        """-> (record, age_ms, fresh) or (None, None, False)."""
        with self._lock:
            rec, t = self._last, self._t
        if rec is None: return None, None, False
        age = (now - t) * 1000.0
        return rec, age, age <= max_age_ms
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
