12mv2/robo-bump-truck-build/(commit log)

2026-10-20 Initial public build guide
    [v10_wedge5.stl, v21b_pin.stl, v26_riser.stl, v26_tray.stl, v66_tbar.stl]
2026-10-20 Clarify power modes, steering clearance and sample availability
